eSpark-Backup/eyadkishawi-powerinterface/Design Files/Power_Board/Renderings/3D_Top_View.PNG

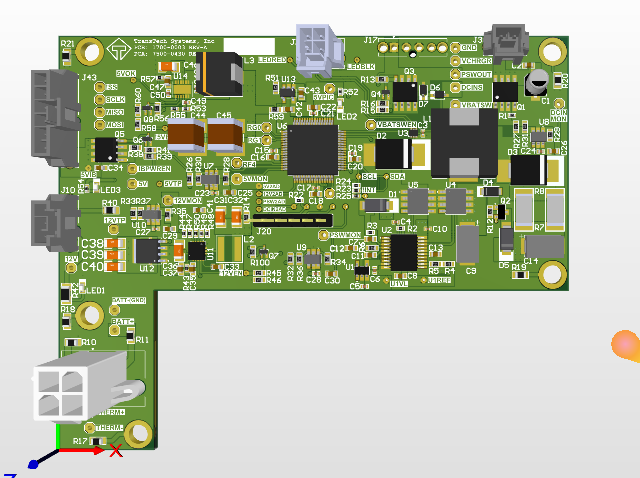
Design Files/Power_Board/Renderings/3D_Top_View.PNG
