eSpark-Backup/eyadkishawi-powerinterface/Design Files/Power_Board/Renderings/2D_C_View.PNG

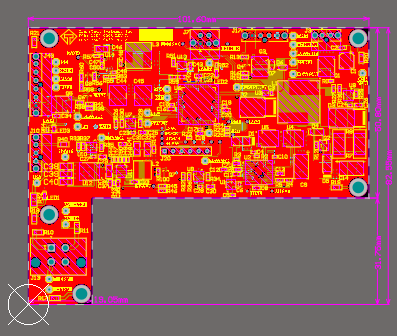
Design Files/Power_Board/Renderings/2D_C_View.PNG
