eSpark-Backup/eyadkishawi-powerinterface/README.md

# Power and Interface Board Design
#### Client Name: Eyad Kishawi
