eSpark-Backup/eyadkishawi-powerinterface/Design Files/Eagle Deliverables/Randerings/2D_TOP.png

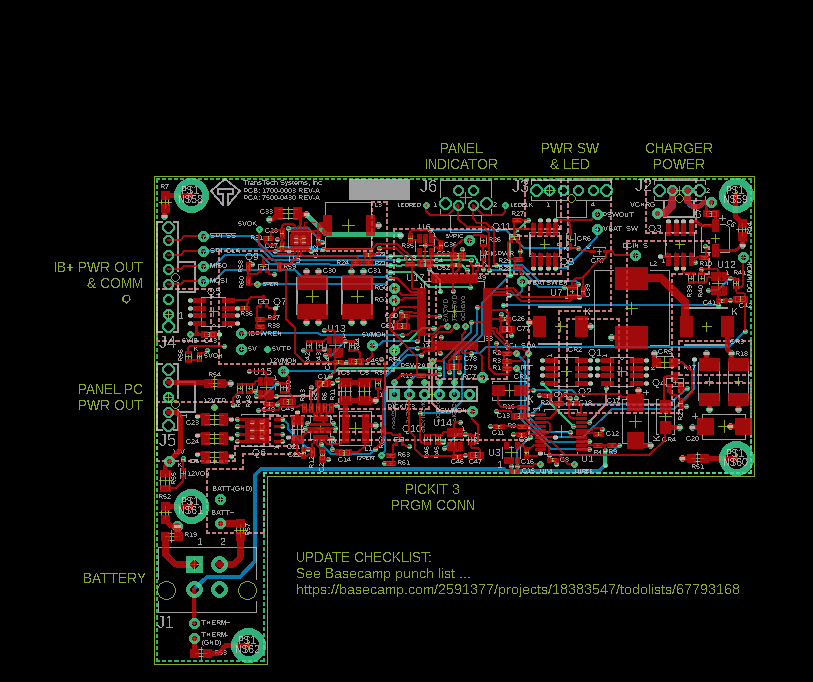
Design Files/Eagle Deliverables/Randerings/2D_TOP.png
