eSpark-Backup/eyadkishawi-powerinterface/Design Files/Power_Board/Renderings/2D_Bottom_Layer.PNG

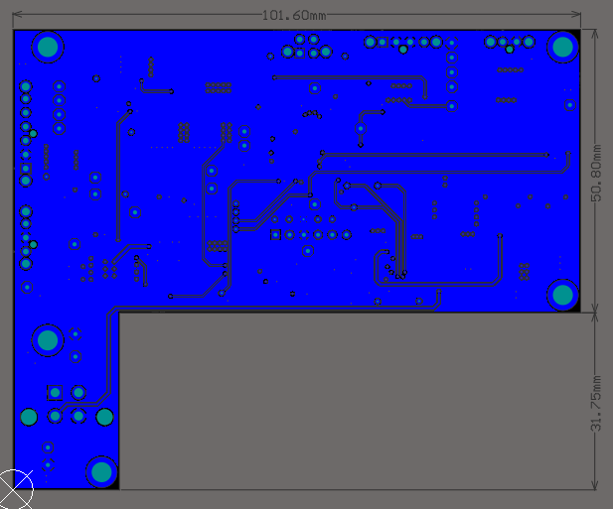
Design Files/Power_Board/Renderings/2D_Bottom_Layer.PNG
