eSpark-Backup/eyadkishawi-powerinterface/Design Files/Power_Board/Renderings/2D_Layer 1.PNG

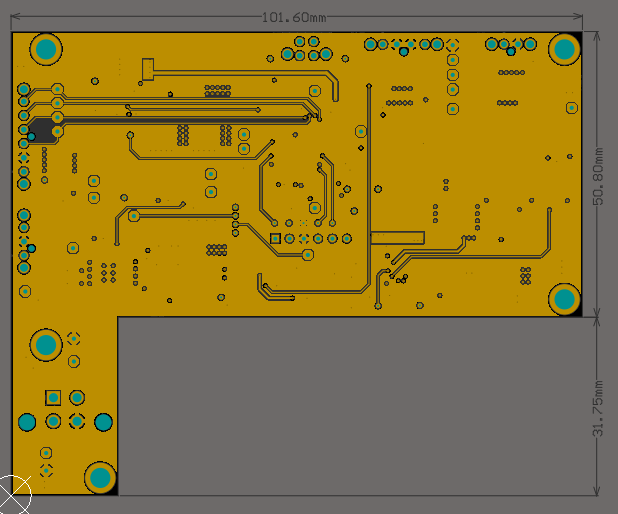
Design Files/Power_Board/Renderings/2D_Layer 1.PNG
