eSpark-Backup/eyadkishawi-powerinterface/Design Files/Power_Board/Renderings/3D_Bottom_View.PNG

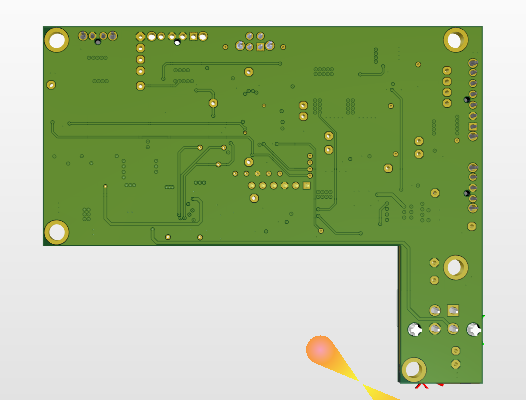
Design Files/Power_Board/Renderings/3D_Bottom_View.PNG
