eSpark-Backup/eyadkishawi-powerinterface/Client_Files/1700-0003_PowerBoard_RevA_071323/7500-0430_PowerBoardAssy_BOM_Rev-A.xlsx

PART | MANUFACTURER | MANUFACTURER_PART_NUMBER | PART_DESC
U4 | TI | TPS61178RNWT | IC REG BOOST ADJ 10A 13VQFN
Q1 | DIODES INC. | DMS3015SSS-13 | N-Channel 30 V 11A (Ta) 1.55W (Ta) Surface Mount 8-SO
Q2 | DIODES INC. | DMS3015SSS-13 | N-Channel 30 V 11A (Ta) 1.55W (Ta) Surface Mount 8-SO
C27 | MURATA |  | --- DO NOT POPULATE ---
U7 | TI | DRV8220DRLR | 20-V, 1-A H-BRIDGE MOTOR DRIVER
C30 | TDK | CKG57NX7R1H476M500JH | 47 µF ±20% 50V Ceramic Capacitor X7R Stacked SMD, 2 J-Lead
C31 | TDK | CKG57NX7R1H476M500JH | 47 µF ±20% 50V Ceramic Capacitor X7R Stacked SMD, 2 J-Lead
Q4 | DIOTEC | BC807-40 | Bipolar Transistors - BJT Bipolar Transistor, SOT-23, 45V, 800mA, PNP
U5 | RENESAS (INTERSIL) | ISL85005AFRZ-T7A | Buck Switching Regulator IC Positive Adjustable 5V 1 Output 5A 12-VFDFN Exposed Pad
C6 | Cornell Dubilier | AFK106M25B12T-F | CAP ALUM 10UF 20% 25V SMD
C8 | MURATA | GCM155R71C104KA55D | CAP CER 0.1UF 16V X7R 0402
C11 | MURATA | GCM155R71C104KA55D | CAP CER 0.1UF 16V X7R 0402
C15 | MURATA | GCM155R71C104KA55D | CAP CER 0.1UF 16V X7R 0402
C16 | MURATA | GCM155R71C104KA55D | CAP CER 0.1UF 16V X7R 0402
C18 | MURATA | GCM155R71C104KA55D | CAP CER 0.1UF 16V X7R 0402
C19 | MURATA | GCM155R71C104KA55D | CAP CER 0.1UF 16V X7R 0402
C26 | MURATA | GCM155R71C104KA55D | CAP CER 0.1UF 16V X7R 0402
C32 | MURATA | GCM155R71C104KA55D | CAP CER 0.1UF 16V X7R 0402
C39 | MURATA | GCM155R71C104KA55D | CAP CER 0.1UF 16V X7R 0402
C41 | MURATA | GCM155R71C104KA55D | CAP CER 0.1UF 16V X7R 0402
C44 | MURATA | GCM155R71C104KA55D | CAP CER 0.1UF 16V X7R 0402
C46 | MURATA | GCM155R71C104KA55D | CAP CER 0.1UF 16V X7R 0402
C48 | MURATA | GCM155R71C104KA55D | CAP CER 0.1UF 16V X7R 0402
C50 | MURATA | GCM155R71C104KA55D | CAP CER 0.1UF 16V X7R 0402
C52 | MURATA | GCM155R71C104KA55D | CAP CER 0.1UF 16V X7R 0402
C78 | MURATA | GCM155R71C104KA55D | CAP CER 0.1UF 16V X7R 0402
C42 | KEMET | C0603C104K3RAC7867 | CAP CER 0.1UF 25V X7R 0603
C45 | KEMET | C0603C104K3RAC7867 | CAP CER 0.1UF 25V X7R 0603
C47 | KEMET | C0603C104K3RAC7867 | CAP CER 0.1UF 25V X7R 0603
C49 | KEMET | C0603C104K3RAC7867 | CAP CER 0.1UF 25V X7R 0603
C7 | SAMSUNG | CL10B104KB8NNNC | CAP CER 0.1UF 50V X7R 0603
C14 | SAMSUNG | CL10B104KB8NNNC | CAP CER 0.1UF 50V X7R 0603
C12 | MURATA | C0402C223K5REC7411 | CAP CER 0402 22NF 50V X7R 10%
C9 | MURATA | C0402C473K3REC7867 | CAP CER 0402 47NF 25V X7R 10%
C43 | MURATA | GRM188D71A106KA73D | CAP CER 10UF 10V X7T 0603
C51 | MURATA | GRM188D71A106KA73D | CAP CER 10UF 10V X7T 0603
C53 | MURATA | GRM188D71A106KA73D | CAP CER 10UF 10V X7T 0603
C77 | MURATA | GRM188D71A106KA73D | CAP CER 10UF 10V X7T 0603
C79 | MURATA | GRM188D71A106KA73D | CAP CER 10UF 10V X7T 0603
C21 | SAMSUNG | CL31B106KBHNNNE | CAP CER 10UF 50V X7R 1206
C29 | MURATA | C0402C120K5RAC7867 | CAP CER 12PF 50V X7R 0402
C28 | MURATA | GRM155R61E105KA12D | CAP CER 1UF 25V X5R 0402
C13 | SAMSUNG | CL10B105KA8NNNC | CAP CER 1UF 25V X7R 0603
C36 | MURATA | GRM155C81C225ME15D | CAP CER 2.2UF 16V X6S 0402
C1 | SAMSUNG | CL10C221JB8NNNC | CAP CER 220PF 50V C0G/NP0 0603
C3 | SAMSUNG | CL31A226KAHNNNE | CAP CER 22UF 25V X5R 1206
C5 | SAMSUNG | CL31A226KAHNNNE | CAP CER 22UF 25V X5R 1206
C33 | SAMSUNG | CL31A226KAHNNNE | CAP CER 22UF 25V X5R 1206
C23 | SAMSUNG | GCM31CC81E226KE11L | CAP CER 22UF 25V X6S 1206
C24 | SAMSUNG | GCM31CC81E226KE11L | CAP CER 22UF 25V X6S 1206
C25 | SAMSUNG | GCM31CC81E226KE11L | CAP CER 22UF 25V X6S 1206
C2 | MURATA | GRM188Z71C475KE21D | CAP CER 4.7UF 16V X7R 0603
C4 | MURATA | GRM188Z71C475KE21D | CAP CER 4.7UF 16V X7R 0603
C17 | KEMET | T495D226K035ATE300 | CAP TANT 22UF 10% 35V 2917
C20 | KEMET | T495D476K025ATE250 | CAP TANT 47UF 10% 25V 2917
J2 | MOLEX | 1053111302 | CONN HEADER VERT 2POS 2.5MM
J5 | MOLEX | 1053111303 | CONN HEADER VERT 3POS 2.5MM
J6 | MOLEX | 1053121304 | CONN HEADER VERT 4POS 2.5MM
J4 | MOLEX | 1053111206 | CONN HEADER VERT 6POS 2.5MM
PICKIT3 | AMPHENOL | 10129378-906001BLF | Connector Header Through Hole 6 position 0.100 (2.54mm)"
CR1 | DIODES INC. | ES1A-13-F | DIODE GEN PURP 50V 1A SMA
CR4 | DIODES INC. | ES1A-13-F | DIODE GEN PURP 50V 1A SMA
CR6 | TOSHIBA | 1SS404 | DIODE SCHOTTKY 20V 300MA USC
CR7 | TOSHIBA | 1SS404 | DIODE SCHOTTKY 20V 300MA USC
CR2 | DIODES INC. | B560CQ-13-F | DIODE SCHOTTKY 60V 5A SMC
CR3 | DIODES INC. | B560CQ-13-F | DIODE SCHOTTKY 60V 5A SMC
CR5 | VISHAY | BZD27C4V3P-E3-08 | DIODE ZENER 4.3V 800MW DO219AB
R31 | --- | --- | DNP - RES 0402
L2 | EATON | DR127-220-R | FIXED IND 22UH 4A 39.1 MOHM SMD
L3 | EATON | DRA74-3R3-R | FIXED IND 3.3UH 4.16A 16MOHM SMD
L1 | COILCRAFT | XAL5030-122MEC | Fixed Inductors 1.2uH Shld 20% 11.1A 9.4mOhms AECQ2
J3 | MOLEX | 1053111304 | HEADER, NANOFIT, VERT, 4 POS 2.5mm
U1 | MAXIM | MAX1647EAP+ | IC BATT CHG MULTI-CHEM 20SSOP
U17 | MICROCHIP | PIC18F6627T-E/PT | IC MCU 8BIT 96KB FLASH 64TQFP
U12 | TI | OPA363AIDBVR | IC OPAMP GP 1 CIRCUIT SOT23-6
U13 | TI | OPA363AIDBVR | IC OPAMP GP 1 CIRCUIT SOT23-6
U14 | TI | OPA363AIDBVR | IC OPAMP GP 1 CIRCUIT SOT23-6
U15 | TI | OPA363AIDBVR | IC OPAMP GP 1 CIRCUIT SOT23-6
5VON | DIALIGHT | 598-8081-107F | LED GREEN CLEAR 0603 SMD
12VON | DIALIGHT | 598-8081-107F | LED GREEN CLEAR 0603 SMD
PICPWR | DIALIGHT | 598-8081-107F | LED GREEN CLEAR 0603 SMD
U6 | STM | LD2981CM50TR | Linear Voltage Regulator IC Positive Fixed 1 Output 100mA SOT-23-5
R23 | VISHAY | MCS0402MD4993BE000 | MCS 0402-25 0.1% AT E0 499K
J1 | MOLEX | 462075004 | MINI-FIT JR LCP VERT. HDR PEGS 4
Q6 | VISHAY | SI7145DP-T1-GE3 | MOSFET P-CH 30V 60A PPAK SO-8
Q3 | ALPHA & OMEGA | AO4485 | MOSFET P-CH 40V 10A 8SOIC
Q5 | ALPHA & OMEGA | AO4485 | MOSFET P-CH 40V 10A 8SOIC
Q8 | ALPHA & OMEGA | AO4485 | MOSFET P-CH 40V 10A 8SOIC
C22 | MURATA | GRM155R71E223KA61D | Multilayer Ceramic Capacitors MLCC - SMD/SMT .022UF 25V 10% 0402
!12VEN |  |  | PCB FEATURE
5V2AD |  |  | PCB FEATURE
5VIB |  |  | PCB FEATURE
5VTP |  |  | PCB FEATURE
12V2AD |  |  | PCB FEATURE
12VTP |  |  | PCB FEATURE
DCIN2AD |  |  | PCB FEATURE
LEDBLK |  |  | PCB FEATURE
LEDRED |  |  | PCB FEATURE
PSW2AD |  |  | PCB FEATURE
U1REF |  |  | PCB FEATURE
U1VL |  |  | PCB FEATURE
PTH1 |  |  | PCB feature, PTH 4-40, ID 148mil, OD 220mil
PTH2 |  |  | PCB feature, PTH 4-40, ID 148mil, OD 220mil
PTH3 |  |  | PCB feature, PTH 4-40, ID 148mil, OD 220mil
PTH4 |  |  | PCB feature, PTH 4-40, ID 148mil, OD 220mil
PTH5 |  |  | PCB feature, PTH 4-40, ID 148mil, OD 220mil
!5VEN |  |  | PCB FEATURE, TEST POINT, ID 20MIL, OD 40MIL
!INT! |  |  | PCB FEATURE, TEST POINT, ID 20MIL, OD 40MIL
5VOK |  |  | PCB FEATURE, TEST POINT, ID 20MIL, OD 40MIL
5VSENS |  |  | PCB FEATURE, TEST POINT, ID 20MIL, OD 40MIL
PICKITGND |  |  | PCB FEATURE, TEST POINT, ID 20MIL, OD 40MIL
PICPGC |  |  | PCB FEATURE, TEST POINT, ID 20MIL, OD 40MIL
PICPGD |  |  | PCB FEATURE, TEST POINT, ID 20MIL, OD 40MIL
SCL |  |  | PCB FEATURE, TEST POINT, ID 20MIL, OD 40MIL
SDA |  |  | PCB FEATURE, TEST POINT, ID 20MIL, OD 40MIL
VPP!MCLR! |  |  | PCB FEATURE, TEST POINT, ID 20MIL, OD 40MIL
!SPI_SS! |  |  | PCB feature, test point, ID 42mil, OD 72mil
5V |  |  | PCB feature, test point, ID 42mil, OD 72mil
5VMON |  |  | PCB feature, test point, ID 42mil, OD 72mil
5VPIC |  |  | PCB feature, test point, ID 42mil, OD 72mil
12V |  |  | PCB feature, test point, ID 42mil, OD 72mil
12VMON |  |  | PCB feature, test point, ID 42mil, OD 72mil
BATT+ |  |  | PCB feature, test point, ID 42mil, OD 72mil
BATT-(GND) |  |  | PCB feature, test point, ID 42mil, OD 72mil
DCINMON |  |  | PCB feature, test point, ID 42mil, OD 72mil
DCIN_S |  |  | PCB feature, test point, ID 42mil, OD 72mil
GND |  |  | PCB feature, test point, ID 42mil, OD 72mil
IBPWREN |  |  | PCB feature, test point, ID 42mil, OD 72mil
MISO |  |  | PCB feature, test point, ID 42mil, OD 72mil
MOSI |  |  | PCB feature, test point, ID 42mil, OD 72mil
PSWMON |  |  | PCB feature, test point, ID 42mil, OD 72mil
PSWOUT |  |  | PCB feature, test point, ID 42mil, OD 72mil
RC7 |  |  | PCB feature, test point, ID 42mil, OD 72mil
RF4 |  |  | PCB feature, test point, ID 42mil, OD 72mil
RG0 |  |  | PCB feature, test point, ID 42mil, OD 72mil
RG1 |  |  | PCB feature, test point, ID 42mil, OD 72mil
SPI_CLK |  |  | PCB feature, test point, ID 42mil, OD 72mil
THERM+ |  |  | PCB feature, test point, ID 42mil, OD 72mil
THERM- |  |  | PCB feature, test point, ID 42mil, OD 72mil
VBATSWEN |  |  | PCB feature, test point, ID 42mil, OD 72mil
VBAT_SW |  |  | PCB feature, test point, ID 42mil, OD 72mil
VCHRG |  |  | PCB feature, test point, ID 42mil, OD 72mil
R7 | STACKPOLE | HCJ0805ZT0R00 | RES 0 OHM JUMPER 1/2W 0805
R14 | STACKPOLE | HCJ0805ZT0R00 | RES 0 OHM JUMPER 1/2W 0805
R19 | STACKPOLE | HCJ0805ZT0R00 | RES 0 OHM JUMPER 1/2W 0805
R51 | STACKPOLE | HCJ0805ZT0R00 | RES 0 OHM JUMPER 1/2W 0805
R52 | STACKPOLE | HCJ0805ZT0R00 | RES 0 OHM JUMPER 1/2W 0805
R53 | STACKPOLE | HCJ0805ZT0R00 | RES 0 OHM JUMPER 1/2W 0805
R54 | STACKPOLE | HCJ0805ZT0R00 | RES 0 OHM JUMPER 1/2W 0805
R57 | STACKPOLE | HCJ0805ZT0R00 | RES 0 OHM JUMPER 1/2W 0805
R17 | TECONN | TLRP3A20CR090FTE | RES 0.09 OHM 1% 2W 2512
R18 | TECONN | TLRP3A20CR090FTE | RES 0.09 OHM 1% 2W 2512
R26 | STACKPOLE | RMCF0603FT1K15 | RES 1.15K OHM 1% 1/10W 0603
R56 | STACKPOLE | RMCF0603FT1K15 | RES 1.15K OHM 1% 1/10W 0603
R16 | VISHAY | CRCW040210R0FKEDC | RES 10 OHM 1% 1/16W 0402
R20 | VISHAY | CRCW040210R0FKEDC | RES 10 OHM 1% 1/16W 0402
R30 | STACKPOLE | RNCS0603BKE10K0 | RES 10K OHM 0.1% 1/16W 0603
R40 | STACKPOLE | RNCS0603BKE10K0 | RES 10K OHM 0.1% 1/16W 0603
R42 | STACKPOLE | RNCS0603BKE10K0 | RES 10K OHM 0.1% 1/16W 0603
R45 | STACKPOLE | RNCS0603BKE10K0 | RES 10K OHM 0.1% 1/16W 0603
R48 | STACKPOLE | RNCS0603BKE10K0 | RES 10K OHM 0.1% 1/16W 0603
R1 | VISHAY | CRCW040210K0FKEDC | RES 10K OHM 1% 1/16W 0402
R2 | VISHAY | CRCW040210K0FKEDC | RES 10K OHM 1% 1/16W 0402
R3 | VISHAY | CRCW040210K0FKEDC | RES 10K OHM 1% 1/16W 0402
R4 | VISHAY | CRCW040210K0FKEDC | RES 10K OHM 1% 1/16W 0402
R8 | VISHAY | CRCW040210K0FKEDC | RES 10K OHM 1% 1/16W 0402
R9 | VISHAY | CRCW040210K0FKEDC | RES 10K OHM 1% 1/16W 0402
R10 | VISHAY | CRCW040210K0FKEDC | RES 10K OHM 1% 1/16W 0402
R15 | VISHAY | CRCW040210K0FKEDC | RES 10K OHM 1% 1/16W 0402
R21 | VISHAY | CRCW040210K0FKEDC | RES 10K OHM 1% 1/16W 0402
R25 | VISHAY | CRCW040210K0FKEDC | RES 10K OHM 1% 1/16W 0402
R27 | VISHAY | CRCW040210K0FKEDC | RES 10K OHM 1% 1/16W 0402
R29 | VISHAY | CRCW040210K0FKEDC | RES 10K OHM 1% 1/16W 0402
R35 | VISHAY | CRCW040210K0FKEDC | RES 10K OHM 1% 1/16W 0402
R36 | VISHAY | CRCW040210K0FKEDC | RES 10K OHM 1% 1/16W 0402
R37 | VISHAY | CRCW040210K0FKEDC | RES 10K OHM 1% 1/16W 0402
R58 | VISHAY | CRCW040210K0FKEDC | RES 10K OHM 1% 1/16W 0402
R59 | VISHAY | CRCW040210K0FKEDC | RES 10K OHM 1% 1/16W 0402
R61 | VISHAY | CRCW040210K0FKEDC | RES 10K OHM 1% 1/16W 0402
R62 | VISHAY | CRCW040210K0FKEDC | RES 10K OHM 1% 1/16W 0402
R5 | STACKPOLE | RMCF0402FT133K | RES 133K OHM 1% 1/16W 0402
R12 | YAGEO | RC0402FR-07178KL | RES 178K OHM 1% 1/16W 0402
R28 | VISHAY | CRCW04021K00FKEDC | RES 1K OHM 1% 1/16W 0402
R38 | VISHAY | CRCW04021K00FKEDC | RES 1K OHM 1% 1/16W 0402
R60 | VISHAY | CRCW04021K00FKEDC | RES 1K OHM 1% 1/16W 0402
R63 | VISHAY | CRCW04021K00FKEDC | RES 1K OHM 1% 1/16W 0402
R55 | VISHAY | CRCW12064K64FKEAC | RES 4.64K OHM 1% 1/4W 1206
R24 | VISHAY | TNPW040295K3BEED | RES 95.3K OHM 0.1% 1/16W 0402
R41 | TECONN | CPF0603F100RC1 | RES SMD 100 OHM 1% 1/16W 0603
R44 | TECONN | CPF0603F100RC1 | RES SMD 100 OHM 1% 1/16W 0603
R47 | TECONN | CPF0603F100RC1 | RES SMD 100 OHM 1% 1/16W 0603
R50 | TECONN | CPF0603F100RC1 | RES SMD 100 OHM 1% 1/16W 0603
R43 | TECONN | CPF0603B15KE1 | RES SMD 15K OHM 0.1% 1/16W 0603
R46 | TECONN | CPF0603B18KE1 | RES SMD 18K OHM 0.1% 1/16W 0603
R39 | TECONN | CPF0603B30KE1 | RES SMD 30K OHM 0.1% 1/16W 0603
R49 | TECONN | CPF0603B30KE1 | RES SMD 30K OHM 0.1% 1/16W 0603
R22 | VISHAY | CRCW040280K6FKED | RES SMD 80.6K OHM 1% 1/16W 0402
R6 | TECONN | CPF0402B86K6E1 | RES SMD 86.6KOHM 0.1% 1/16W 0402
U3 | AD | ADR364AUJZ-REEL7 | Series Voltage Reference IC Fixed 4.096V V ±0.2% 5 mA TSOT-23-5
R11 | VISHAY | CRCW0402174KFKTD | Thick Film Resistors - SMD 1/16watt 174Kohms 1%
R13 | VISHAY | CRCW0402732KFKED | Thick Film Resistors - SMD 1/16watt 732Kohms 1%
Q7 | ONSEMI | MMBT2222ATT3G | TRANS NPN 40V 0.6A SC75 SOT416
Q9 | ONSEMI | MMBT2222ATT3G | TRANS NPN 40V 0.6A SC75 SOT416
Q10 | ONSEMI | MMBT2222ATT3G | TRANS NPN 40V 0.6A SC75 SOT416
Q11 | ONSEMI | MMBT2222ATT3G | TRANS NPN 40V 0.6A SC75 SOT416
