eSpark-Backup/eyadkishawi-powerinterface/Design Files/Power_Board/BOM/Client BOM.xlsx

# | Item Type | Designator | Description | Footprint | Manufacturer Part Number | Manufacturer | Value | Quantity | Remarks
1 | Capacitor | C1 | CAP ALUM 10UF 20% 25V SMD | Custom | EEE-FK1E100R | Panasonic | 10uF | 1
2 | Capacitor | C2, C8, C12, C25, C26, C29, C30, C33 | CAP CER 0.1UF 50V X7R 0603 | Cap-0603 | CL10B104KB8NNNC | Samsung | 0.1uF | 8
3 | Capacitor | C3, C4, C5, C6, C10, C15, C17, C19, C21, C23, C24, C27, C28, C48 | CAP CER 0.1UF 16V X7R 0402 | Cap-0402 | GRM155R71C104KA88D | Murata | 0.1uF | 14
4 | Capacitor | C7, C43, C47 | CAP CER 1UF 25V X5R 0603 | Cap-0603 | CC0603KRX5R8BB105 | Yageo | 1uF | 3
5 | Capacitor | C9 | CAP TANT 22UF 10% 35V 2917 | Case-D | T495D226K035ATE3007280 | KEMET | 22uF | 1
6 | Capacitor | C11 | CAP CER 0.047UF 50V X8R 0603 | Cap-0603 | CGA3E2X8R1H473M080AA | TDK | 47nF | 1
7 | Capacitor | C13, C37 | CAP CER 0.022UF 50V X7R 0603 | Cap-0603 | CC0603KRX7R9BB223 | Yageo | 22nF | 2
8 | Capacitor | C14 | CAP TANT 47UF 10% 25V 2917 | Case-D | T495D476K025ATE250 | KEMET | 47uF | 1
9 | Capacitor | C16, C18, C20, C22 | 10V 10uF X5R ±10% 0603 Multilayer Ceramic Capacitors MLCC - SMD/SMT ROHS | Cap-0603 | CGA0603X5R106K100JT | HRE | 10uF | 4
10 | Capacitor | C31, C32, C38, C39, C40, C46 | Multilayer Ceramic Capacitor, 22 uF, 25 V, ± 20%, X5R, 1206 [3216 Metric] | Cap-1206 | C3216X5R1E226M160AB | TDK | 22uF | 6
11 | Capacitor | C34 | CAP CER 10UF 10V X5R 0603 | Cap-0603 | CC0603KRX5R6BB106 | Yageo | 10uF | 1
12 | Capacitor | C35, C42 | CAP CER 4.7UF 16V X5R 0603 | Cap-0603 | CC0603KRX5R7BB475 | Yageo | 4.7uF | 2
13 | Capacitor | C36 | CAP CER 10UF 50V X5R 1206 | Cap-1206 | CC1206KKX5R9BB106 | Yageo | 10uF | 1
14 | Capacitor | C41 | 50V 220pF X7R ±10% 0603 Multilayer Ceramic Capacitors MLCC - SMD/SMT ROHS | Cap-0603 | CS1608X7R221K500NRB | Samwha Capacitors | 220pF | 1
15 | Capacitor | C44, C45 | CAP CER 47UF 50V X7R 2SMD | Custom | CKG57NX7R1H476M500JH | TDK | 47uF | 2
16 | Capacitor | C49 | CAP CER 12PF 50V C0G/NP0 0402 | Cap-0402 | GJM1555C1H120GB01D | Murata | 12pF | 1
17 | Capacitor | C50 | CAP CER 0.1UF 16V X7R 0402 | Cap-0402 | GRM155R71C104KA88D | Murata | DNP | 1 | DO NOT PLACE
18 | Diodes | D1, D5 | DIODE GEN PURP 50V 1A SMA | SMA | ES1A-13-F | Diodes | - | 2
19 | Diode | D2, D3 | DIODE SCHOTTKY 60V 5A SMC | SMC | B560CQ-13-F | Diodes | - | 2
20 | Diodes | D4 | Zener Diode, 4.3V V(Z), 6.98%, 0.8W, Silicon, Unidirectional, DO-219AB | DO-219AB (SMF) | BZD27C4V3P-E3-08 | Vishay Semiconductors | - | 1
21 | Diode | D6, D7 | Diode Schottky Barrier 25V 0.3A 2 SOD-323 | SOD-323 | 1SS404,H3F | Toshiba | - | 2
22 | Headers | J3 | CONN HEADER VERT 2POS 2.5MM | TH-2.5mm | 1053111302 | Molex | - | 1
23 | Header | J7 | CONN HEADER VERT 4POS 2.5MM | TH-2.5mm | 105312-1304 | Molex | - | 1
24 | Header | J10 | CONN HEADER VERT 3POS 2.5MM | TH-2.5mm | 105311-1303 | Molex | - | 1
25 | Header | J13 | MINI-FIT JR LCP VERT. HDR PEGS 4 | TH-4.2mm | 462075004 | Molex | - | 1
26 | Header | J17 | CONN HEADER VERT 4POS 2.5MM | TH-2.5mm | 105311-1304 | Molex | - | 1
27 | Header | J20 | Gold 250V 3A Straight Square Pins 2.5mm 6P 260℃ 6mm -40℃~+105℃ 3mm 2.54mm Plugin Black Brass 1x6P Plugin,P=2.54mm Pin Headers ROHS | TH-2.5mm | X6511WV-06H-C60D30 | XKB | - | 1
28 | Header | J43 | CONN HEADER VERT 6POS 2.5MM | TH-2.5mm | 105311-1206 | Molex | - | 1
29 | Inductors | L1 | FIXED IND 22UH 4A 39.1 MOHM SMD | Custom | DR127-220-R | Eaton Cooper | 22uH | 1
30 | Inductors | L2 | FIXED IND 1.2UH 10.4A 12.4MOHM | Custom | XAL5030-122MEC | Coilcraft | 1.2uH | 1
31 | Inductors | L3 | FIXED IND 3.3UH 4.16A 16MOHM SMD | Custom | DRA74-3R3-R | Eaton Cooper | 3.3uH | 1
32 | LED | LED1, LED2, LED3 | Emerald 0603 Light Emitting Diodes (LED) ROHS | LED-0603 | NCD0603G2 | Foshan NationStar Optoelectronics | - | 3
33 | Transistor | Q1, Q3, Q5 | MOSFET P-CH 40V 10A 8SOIC | SOIC-8 | AO4485 | Alpha & Omega Semiconductor | - | 3
34 | Transistor | Q2 | 45V 310mW 250@100mA,1V 800mA SOT-23 Bipolar (BJT) ROHS | SOT-23 | BC807-40 | KEXIN | - | 1
35 | Transistor | Q4, Q6, Q7, Q8 | Small Signal Bipolar Transistor, 0.6A I(C), 40V V(BR)CEO, 1-Element, NPN, Silicon | SOT-416 | MMBT2222ATT3G | ON Semiconductor | - | 4
36 | Resistor | R1, R22, R23, R24, R25 | RES 10K OHM 1% 1/16W 0402 | Res-0402 | RC0402FR-0710KL | Yageo | 10K | 5
37 | Resistor | R2, R3 | RES SMD 10 OHM 1% 1/5W 0402 | Res-0402 | CRCW040210R0FKEDHP | Vishay Dale | 10R | 2
38 | Resistor | R4, R5, R6, R12, R13, R16, R38, R41, R46, R51, R56, R59, R60, R100 | RES 10K OHM 1% 1/10W 0603 | Res-0603 | RK73G1JTTD1002F | KOA Speer Electronics, Inc. | 10K | 14
39 | Resistor | R26, R31, R36, R37 | RES 10K OHM 0.1% 1/16W 0603 | Res-0603 | RNCS0603BKE10K0 | Stackpole Electronics Inc | 10K | 4
40 | Resistor | R7, R8 | Res Current Sense Metal Strip 2512 0.09 Ohm 1% 2W ±25ppm/°C Molded Emboss T/R | RES-2512 | TLRP3A20CR090FTE | CGS | 90mR | 2
41 | Resistor | R10, R11, R17, R18, R19, R20, R21 | RES 0 OHM JUMPER 1/8W 0805 | Res-0805 | RC0805FR-070RL | Yageo | 0R | 7
42 | Resistor | R14 | RES SMD 10K OHM 0.1% 1/10W 0603 | Res-0603 | RT0603BRD0710KL | Yageo | 10K | 1
43 | Resistor | R15, R39, R45, R58 | RES SMD 1K OHM 1% 1/10W 0603 | Res-0603 | RC0603FR-071KL | Yageo | 1K | 4
44 | Resistor | R27, R33 | RES SMD 30K OHM 0.1% 1/16W 0603 | Res-0603 | CPF0603B30KE1 | TE Connectivity Passive Product | 30K | 2
45 | Resistor | R28, R29, R34, R35 | RES SMD 100 OHM 1% 1/10W 0603 | Res-0603 | RC0603FR-07100RL | Yageo | 100R | 4
46 | Resistor | R30 | RES SMD 15K OHM 0.1% 1/16W 0603 | Res-0603 | CPF0603B15KE1 | TE Connectivity Passive Product | 15K | 1
47 | Resistor | R32 | RES SMD 18K OHM 0.1% 1/16W 0603 | Res-0603 | CPF0603B18KE1 | TE Connectivity Passive Product | 18K | 1
48 | Resistor | R40 | HCJ Series 0805 Jumper Surface Mount Chip Resistor | Res-0805 | HCJ0805ZT0R00 | Stackpole Electronics | 0R | 1
49 | Resistor | R42 | 250mW Thick Film Resistors 200V ±100ppm/℃ ±1% 4.64kΩ 1206 Chip Resistor - Surface Mount ROHS | Res-1206 | 1206W4F4641T5E | UNI-ROYAL | 4.64K | 1
50 | Resistor | R44 | 62.5mW Thick Film Resistors ±1% ±200ppm/℃ 732kΩ 0402 Chip Resistor - Surface Mount ROHS | Res-0402 | RC-02W7323FT | FH (Guangdong Fenghua Advanced Tech) | 732K | 1
51 | Resistor | R47 | 62.5mW Thick Film Resistors 75V ±1% ±100ppm/℃ 80.6kΩ 0402 Chip Resistor - Surface Mount ROHS | Res-0402 | CRCW040280K6FKED | Vishay Intertech | 80.6K | 1
52 | Resistor | R48 | 62.5mW Thick Film Resistors 50V ±1% ±200ppm/℃ 174kΩ 0402 Chip Resistor - Surface Mount ROHS | Res-0402 | CR0402FF1743G | LIZ Elec | 174K | 1
53 | Resistor | R49 | 62.5mW Thick Film Resistors 50V ±100ppm/℃ ±1% 86.6kΩ 0402 Chip Resistor - Surface Mount ROHS | Res-0402 | RM04FTN8662 | TA-I Tech | 86.6K | 1
54 | Resistor | R43,R50 | 62.5mW Thick Film Resistors 50V ±100ppm/℃ ±1% 133kΩ 0402 Chip Resistor - Surface Mount ROHS | Res-0402 | RTT021333FTH | RALEC | 133K | 2
55 | Resistor | R52, R54 | 100mW Thick Film Resistors 75V ±100ppm/℃ ±1% 1.15kΩ 0603 Chip Resistor - Surface Mount ROHS | Res-0402 | RTT031151FTP | RALAC | 1.15K | 2
56 | Resistor | R53 | RES 499K OHM 0.1% 1/16W 0402 | Res-0402 | RC0402BR-07499KL | Yageo | 499K | 1
57 | Resistor | R55 | RES 95.3K OHM 1% 1/16W 0402 | Res-0402 | RC0402FR-0795K3L | Yageo | 95.3K | 1
58 | Resistor | R57 | RES 95.3K OHM 1% 1/16W 0402 | Res-0402 | RC0402FR-0795K3L | Yageo | DNP | 1 | DO NOT PLACE
59 | IC | U1 | IC VREF SERIES 0.2% TSOT5 | TSOT-23-5 | ADR364AUJZ-REEL7 | Analog Devices | - | 1
60 | IC | U2 | Battery Charger Lead-Acid/Li-Ion/NiCD/NiMH 4000mA 18V 20-Pin SSOP | SSOP-20-208mil | MAX1647EAP+ | Maxim | - | 1
61 | IC | U3 | 20-V, 1-A H-BRIDGE MOTOR DRIVER | SOT-563 | DRV8220DRLR | Texas Instruments | - | 1
62 | IC | U4, U5 | MOSFET N-CH 30V 11A 8SO | SOP-8 | DMS3015SSS-13 | Diodes | - | 2
63 | IC | U6 | IC MCU 8BIT 96KB FLASH 64TQFP | 64-TQFP (10x10) | PIC18F6627T-E/PT | Microchip | - | 1
64 | IC | U7, U8, U9, U10 | IC OPAMP GP 1 CIRCUIT SOT23-6 | SOT-23-6 | OPA363AIDBVR | Texas Instruments | - | 4
65 | IC | U11 | 20-V, 10-A fully integrated sync boost with load disconnect 13-VQFN-HR -40 to 85 | VQFN-13-HR(3x3.5) | TPS611781RNWT | Texas Instruments | - | 1
66 | MOSFET | U12 | MOSFET P-CH 30V 60A PPAK SO-8 | PowerPAK-SO-8 | SI7145DP-T1-GE3 | Vishay Siliconix | - | 1
67 | IC | U13 | LD2981 Series 100 mA 5 V Fixed Output LDO Regulator with Inhibit - SOT-23-5 | SOT-23-5 | LD2981CM50TR | STMicroelectronics | - | 1
68 | IC | U14 | IC REG BUCK ADJ 5A 12DFN | 12-DFN (4x3) | ISL85005AFRZ-T7A | Renesas Electronics Corporation | - | 1
