eSpark-Backup/eyadkishawi-powerinterface/Design Files/Eagle Deliverables/Supporting Files/1700-0003_PowerBoard_REV-A.step

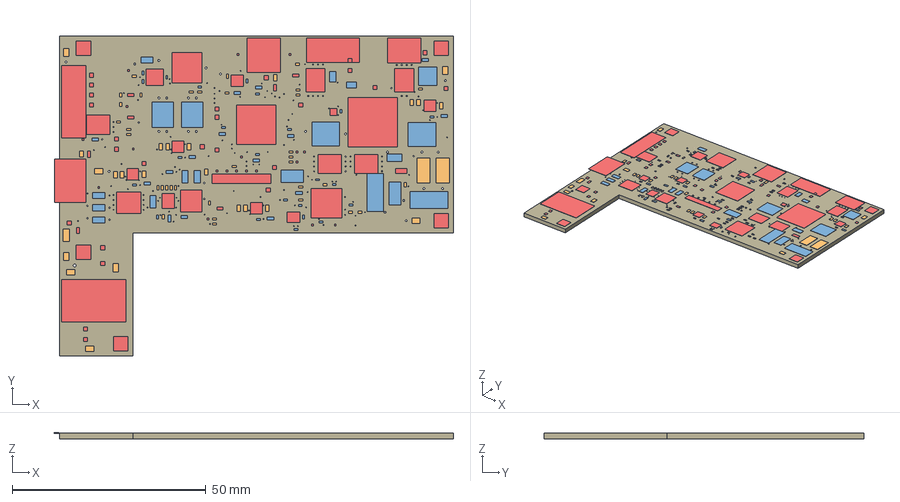
[picture p10: CAD file, 2024-07-15]
Design Files/Eagle Deliverables/Supporting Files/1700-0003_PowerBoard_REV-A.step
102.8 x 82.5 x 1.66 mm
Board
MOLEX_1053111206
TST_POINT_PTH_042-OCT x 22
DNP (0402) x 34
MOLEX_MINI-FIT-JR_462075004
MAX1647EAP+
MOLEX_NANO-FIT_1053111302
MOLEX_NANO-FIT_1053111303
0.1/16V (0402) x 23
AD_REFERENCE_ADR364AUJZ-REEL7
P-CH/40V/10A/8-SOIC x 5
47/25 x 2
1A/50V x 2
22uH/4A/39mOhm
5A/60V/SMC x 2
0.09/2W/2512 x 2
45V/0.8A/SOT23
4.3V/0.8W/DO219AB
REGULATOR_BOOST_TI_TPS61178RNWT
REGULATOR_BUCK_RENESAS_ISL85005AFRZ-T7A
0.1/50V x 15
22/25V (1206) x 7
1.2uH/11.1A/9.4mOhm
P-CH/-30V/-60A/PPAK/SO-8
47/50V x 2
3.3uH/4.2A
NPN/40V/0.6A/SC75 x 4
IC_OPAMP_TI_OPA363AIDBVR x 4
10K, 0.1% x 15
GRN/2.7V/2mA x 3
4.64K
PIC18F6627T-E/PT
IC_LDO_STM_LD2981CM50TR
PTH_4-40 x 5
CON_6POS_VERT-HDR_AMPH_10129378-906001
TST_POINT_PTH_042_2PIN x 4
MOLEX_NANO-FIT_1053111304
0.3A/20V x 2
CON_MOLEX_NANOFIT_1053121304
IC_H-BRIDGE_TI_DRV8220DRLR
TST_POINT_PTH_20X40MIL_2PIN x 10
TST_POINT_PTH_20X40MIL x 12
10/25
