eSpark-Backup/eyadkishawi-powerinterface/Design Files/Power_Board/Supporting Files/PCB_PowerBoard_7500-0430.step

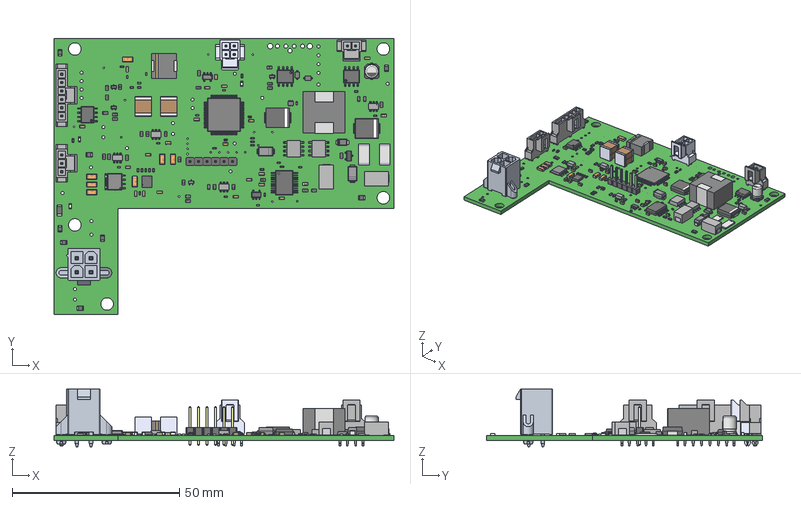
[picture p11: CAD file, 2024-08-13]
Design Files/Power_Board/Supporting Files/PCB_PowerBoard_7500-0430.step
101.6 x 82.5 x 17.3 mm
User Library-Capacitor 0402 x 16
User Library-RES_1005-0402 x 18
User Library-CR3216-1206
CircuitWorks-RESISTOR 2512 x 2
SN74LV1T34DBVR
SQJ148EP-T1_GE3_SQJ148EP-T1_GE3
21-0058I_MXM x 4
TQFP64_10x10MC_MCH
TRANS_IRF7103TRPBF_INF x 2
SOT_X-T1-GE3_VIS
MT8870DN1
User Library-tsot-23-5
User Library-RESC1608X05N x 31
User Library-CR2012-0805 x 8
User Library-SOIC-8-1 x 3
CircuitWorks-SOT-23
User Library-LED SMD0603 x 3
IND_CB_DRA74
DR127
User Library-Header_Male_6Pin_PinArray
User Library-Header_Male_6Pin_BodyArray
1053111303_RGB8421504
1053111302_RGB8421504
User Library-DO-214AC SMA x 2
User Library-DO-214AB-SMC x 2
User Library-CAPC1608X09 x 22
User Library-1206 SMD Capacitor x 7
標準品ケースΦ4x5.3L SIDE CODE B
標準品座版Φ4 SIZE CODE B
標準品リード線Φ4 SIZE CODE B x 2
