eSpark-Backup/eyadkishawi-powerinterface/(list of files, cad)

Other CAD files:
Design Files/Eagle Deliverables/Supporting Files/1700-0003_PowerBoard_REV-A.dxf
Design Files/Power_Board/Supporting Files/PCB_PowerBoard_7500-0430.DWG
Design Files/Power_Board/Supporting Files/PCB_PowerBoard_7500-0430.DXF
