eSpark-Backup/eyadkishawi-powerinterface/Design Files/Power_Board/Schematics/PowerBoard_7500-0430.pdf

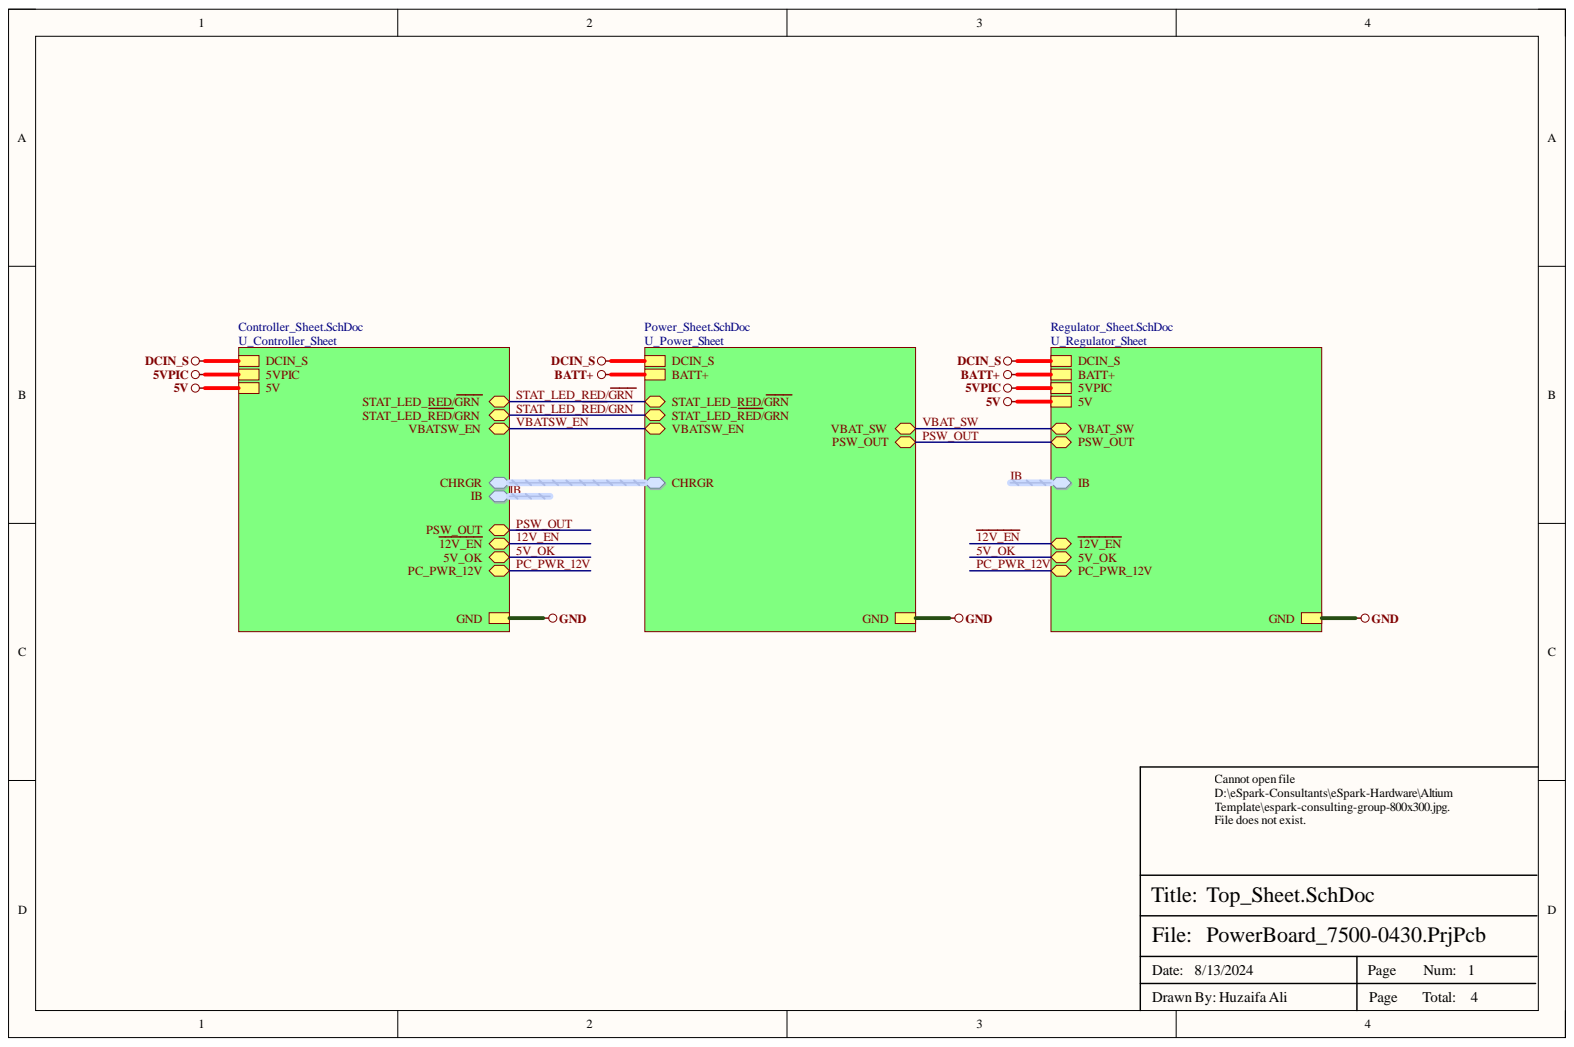
[picture p12: page 1]

Dat e : 8 / 1 3 / 2 0 2 4 | Pag e N u m :

D raw n B y : H uzai fa A l i | Pag e To t al :

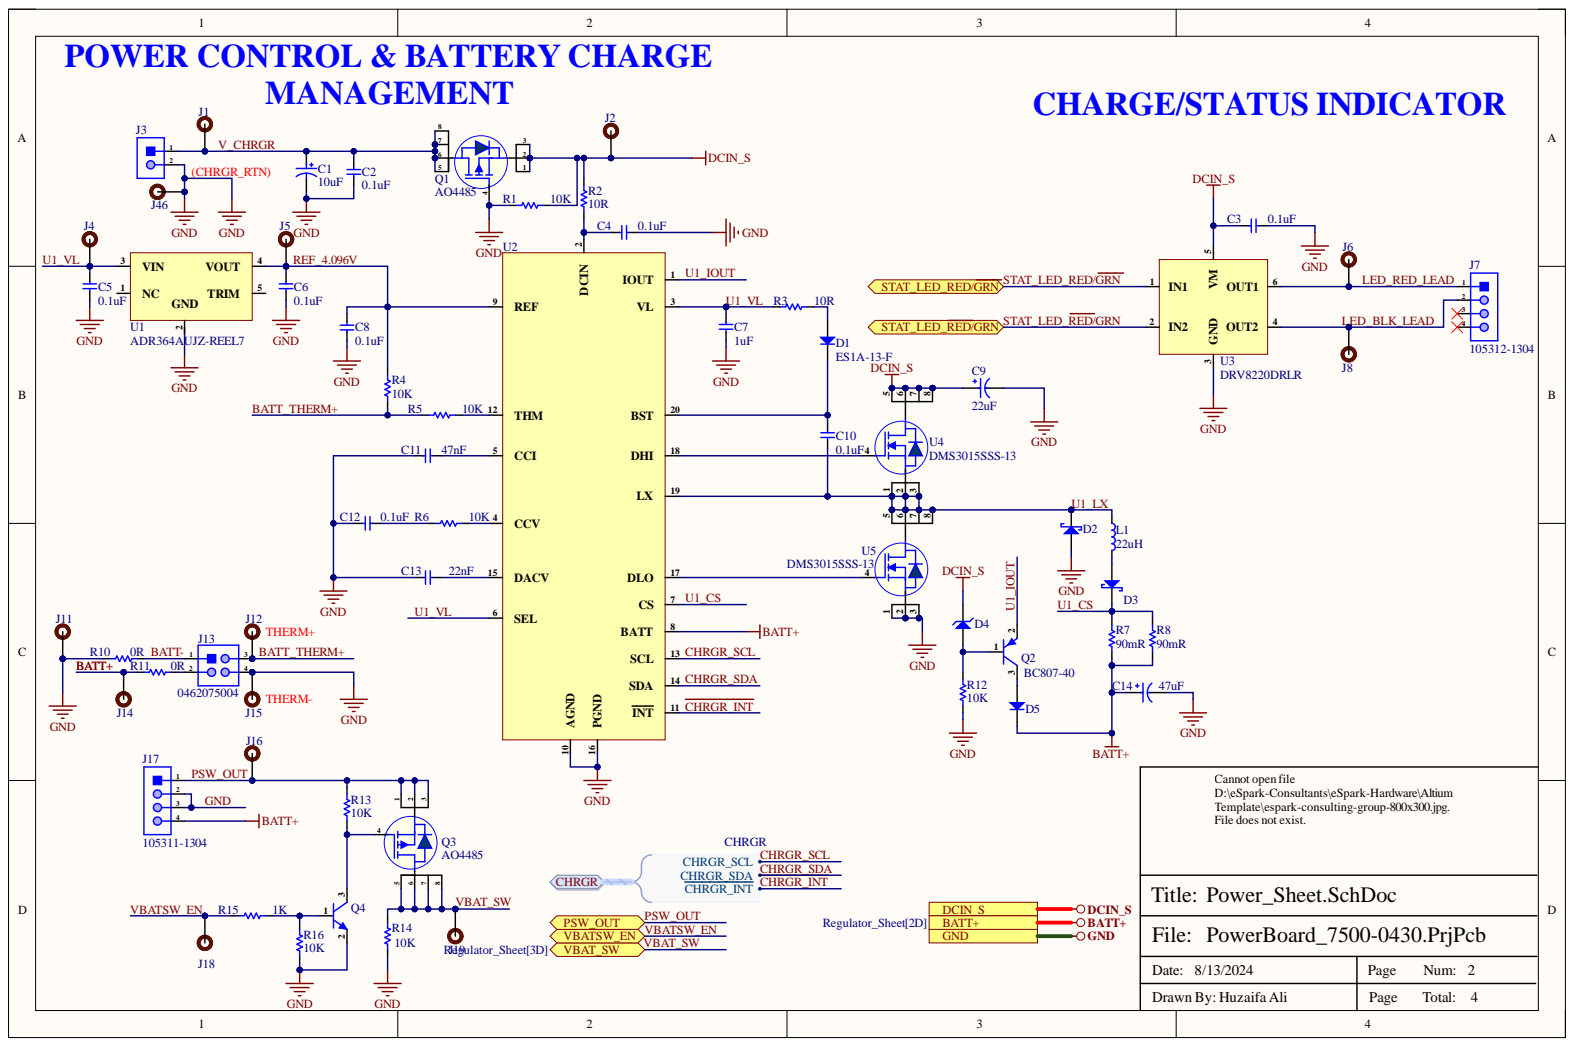
[picture p13: page 2]

POWER CONTROL & BATTERY CHARGE

LED_BLK_LEAD | 3

Cannot open file
D:\eSpark-Consultants\eSpark-Hardware\Altium
Template\espark-consulting-group-800x300.jpg.
File does not exist.

Date: 8/13/2024 | Page Num: 2

Drawn By: Huzaifa Ali | Page Total: 4

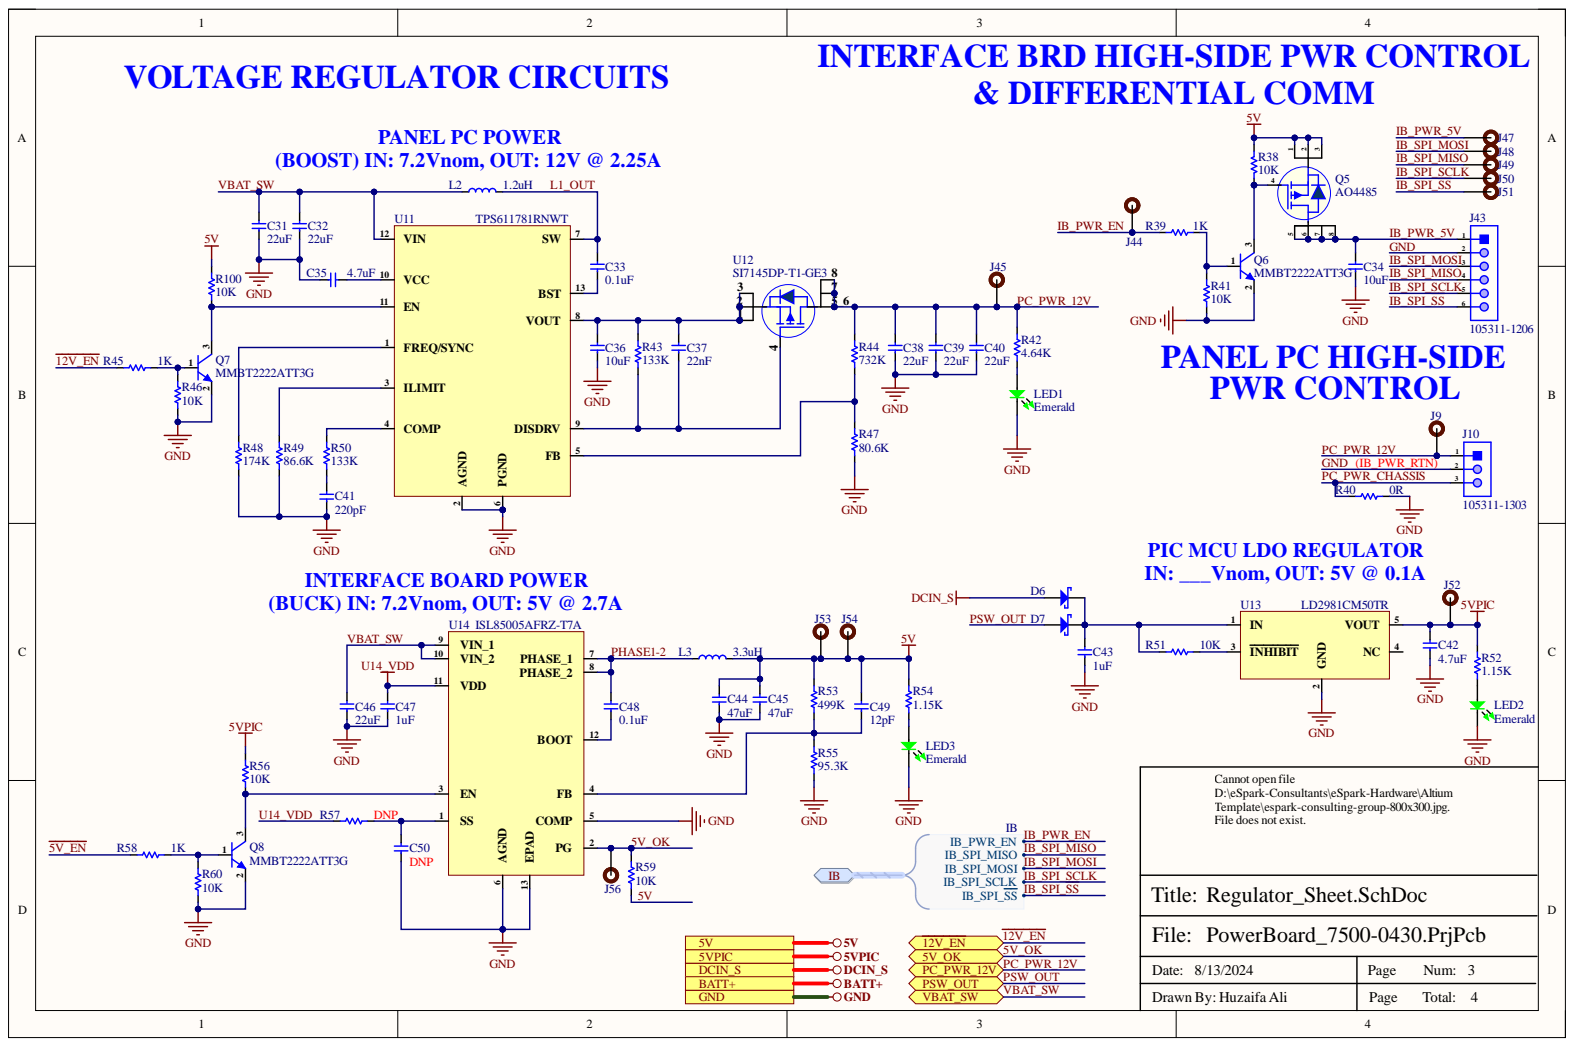
[picture p14: page 3]

INTERFACE BRD HIGH-SIDE PWR CONTROL

PANEL PC HIGH-SIDE
PWR CONTROL

GND

PIC MCU LDO REGULATOR
IN: ___Vnom, OUT: 5V @ 0.1A

U14_VDD

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

Date: 8/13/2024 | Page Num: 3

Drawn By: Huzaifa Ali | Page Total: 4

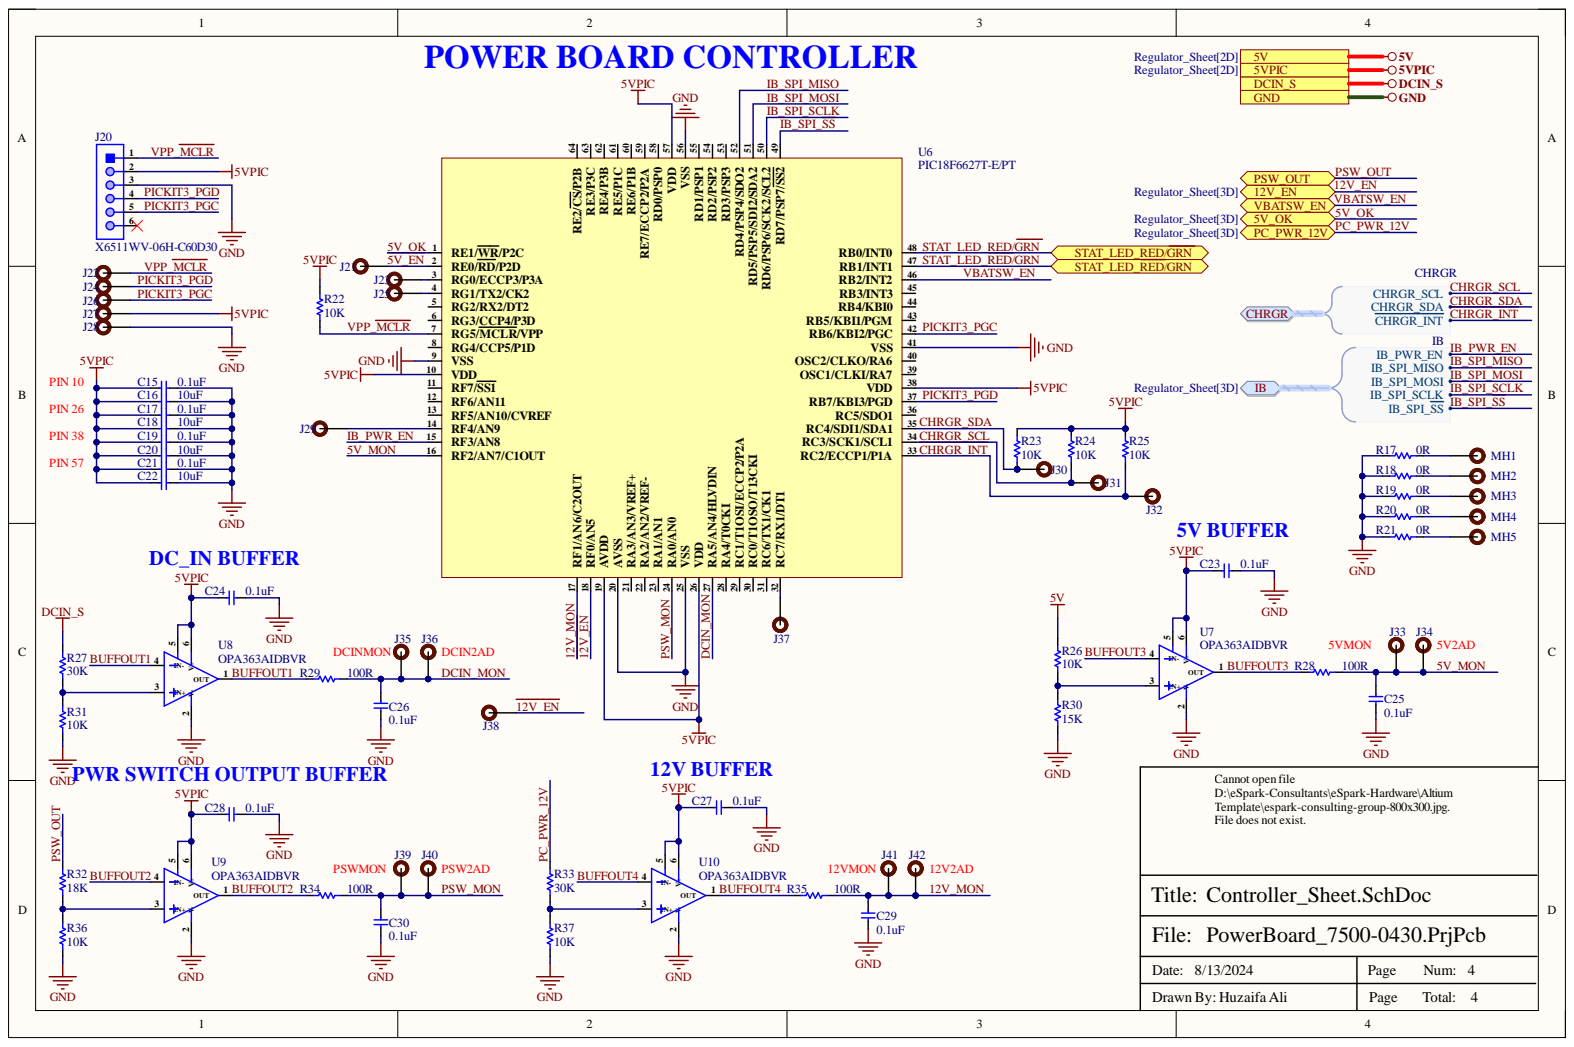
[picture p15: page 4]

C21 | 0.1uF
C22 | | 10uF

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

Date: 8/13/2024 | Page Num: 4

Drawn By: Huzaifa Ali | Page Total: 4

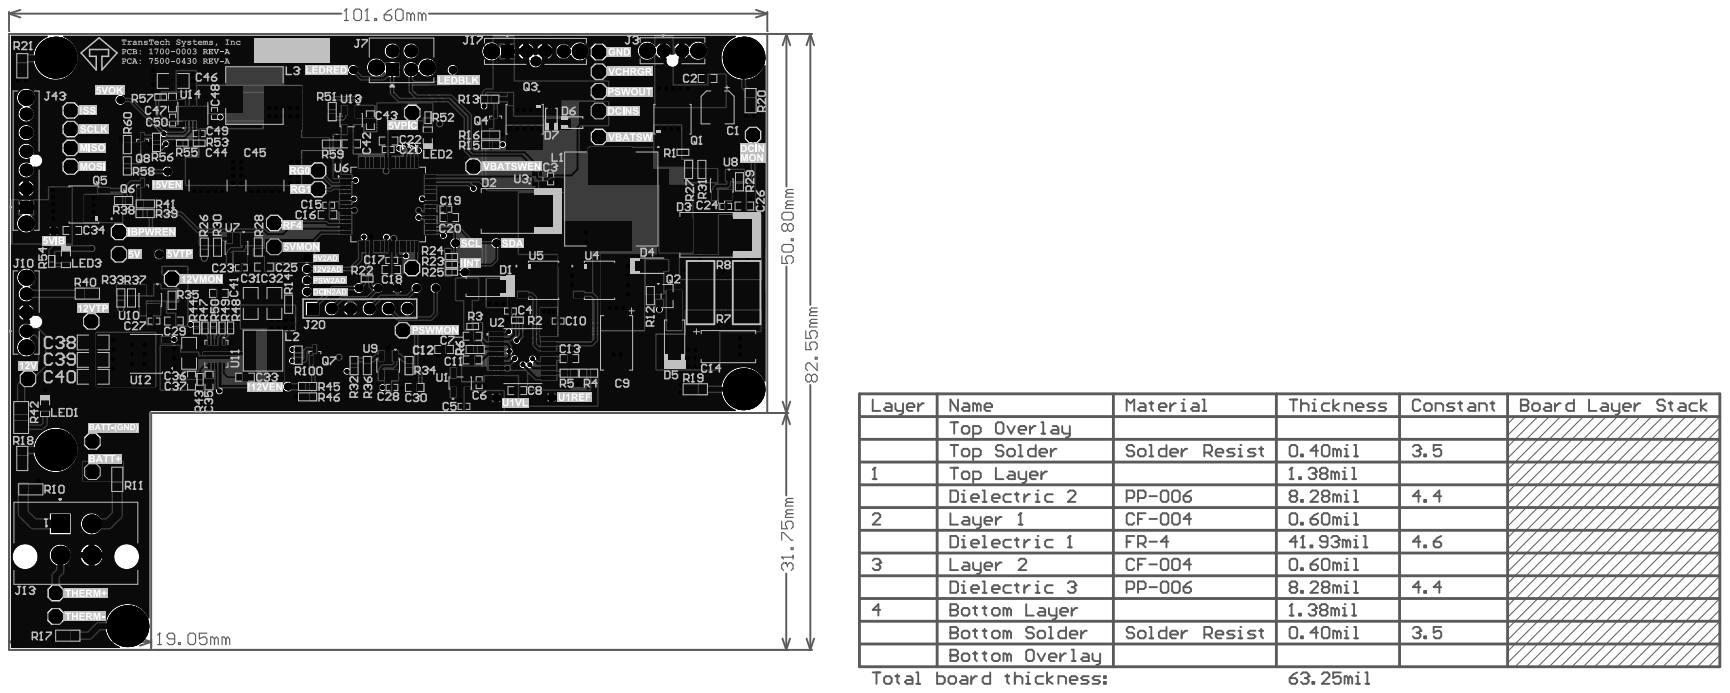
[picture p16: page 5]
