eSpark-Backup/eyadkishawi-powerinterface/Design Files/Eagle Deliverables/PCB_PDF/Power Board.pdf

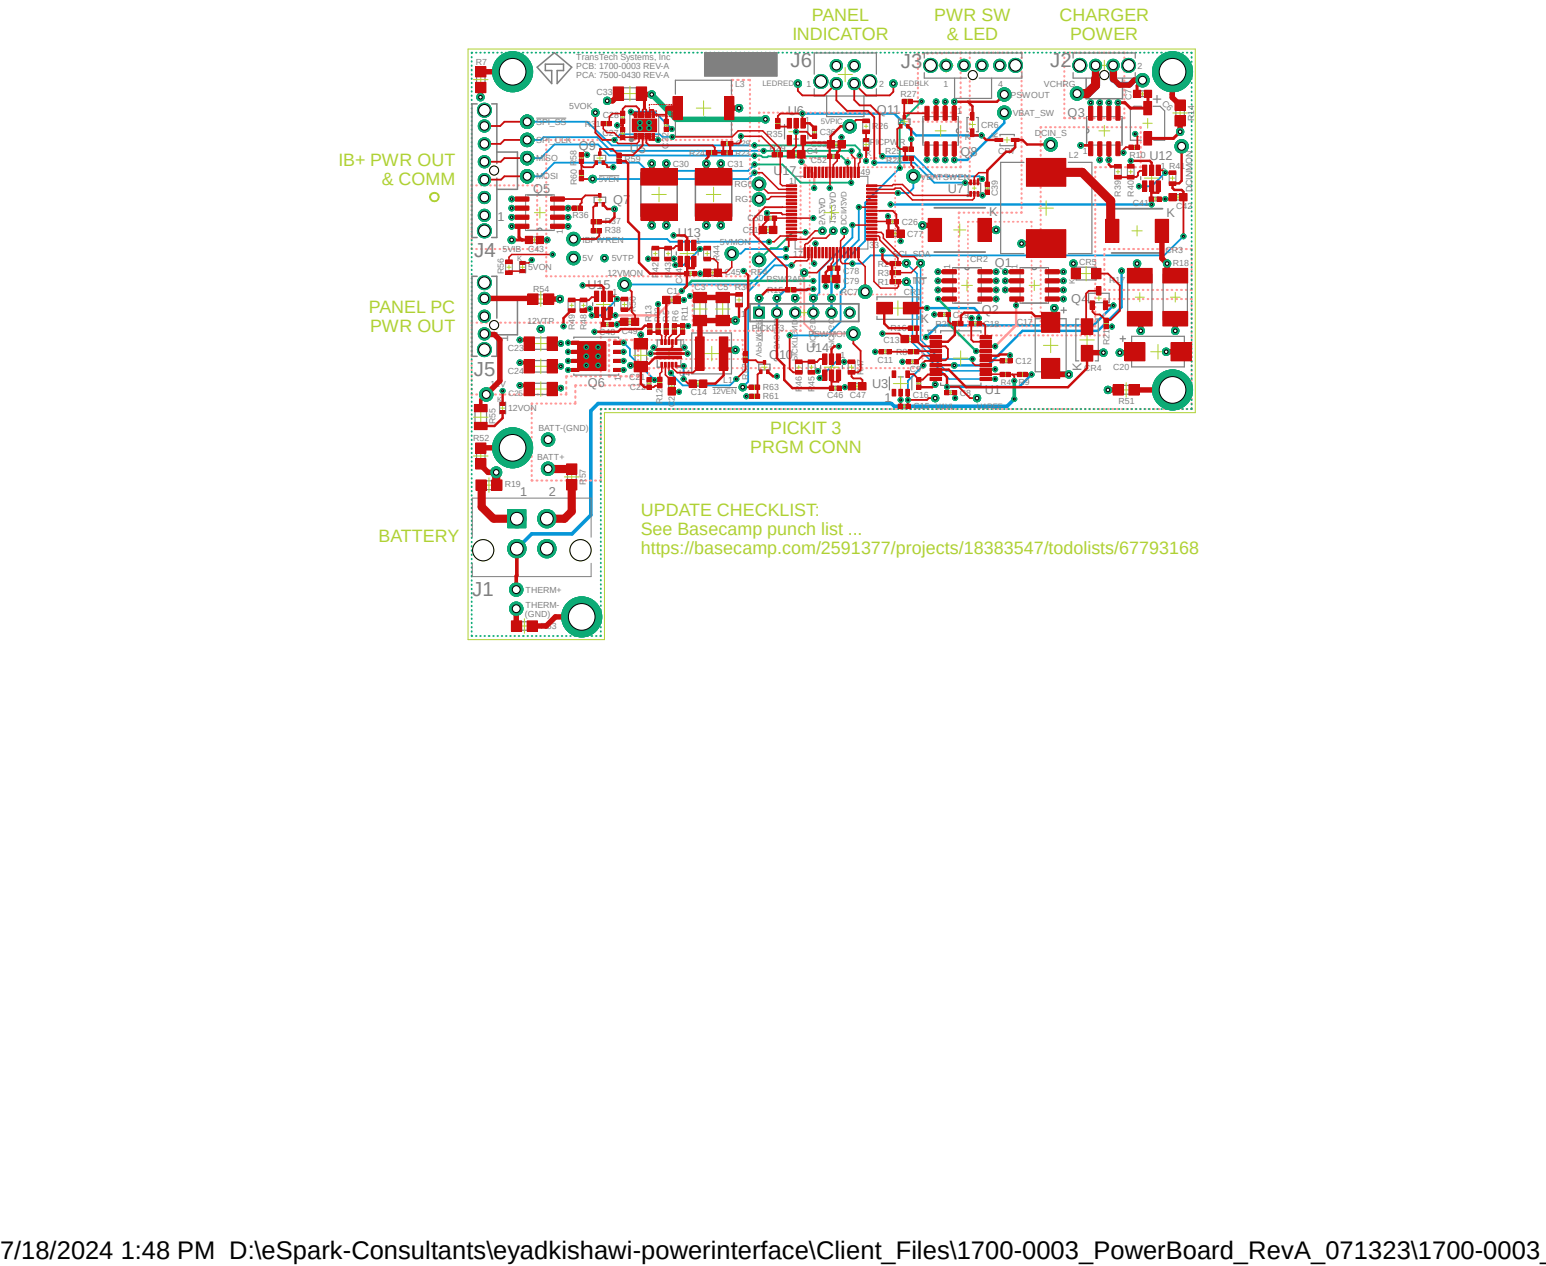
[picture p18: page 1]

J3 R⁵⁷
TransTech Systems, Inc PCB: 1700-0003 REV-A
PCA: 7500-0430 REV-A

UPDATE CHECKLIST:
See Basecamp punch list ...
https://basecamp.com/2591377/projects/18383547/todolists/67793168
