eSpark-Backup/eyadkishawi-powerinterface/Design Files/Eagle Deliverables/Schematic PDF/Power Board.pdf

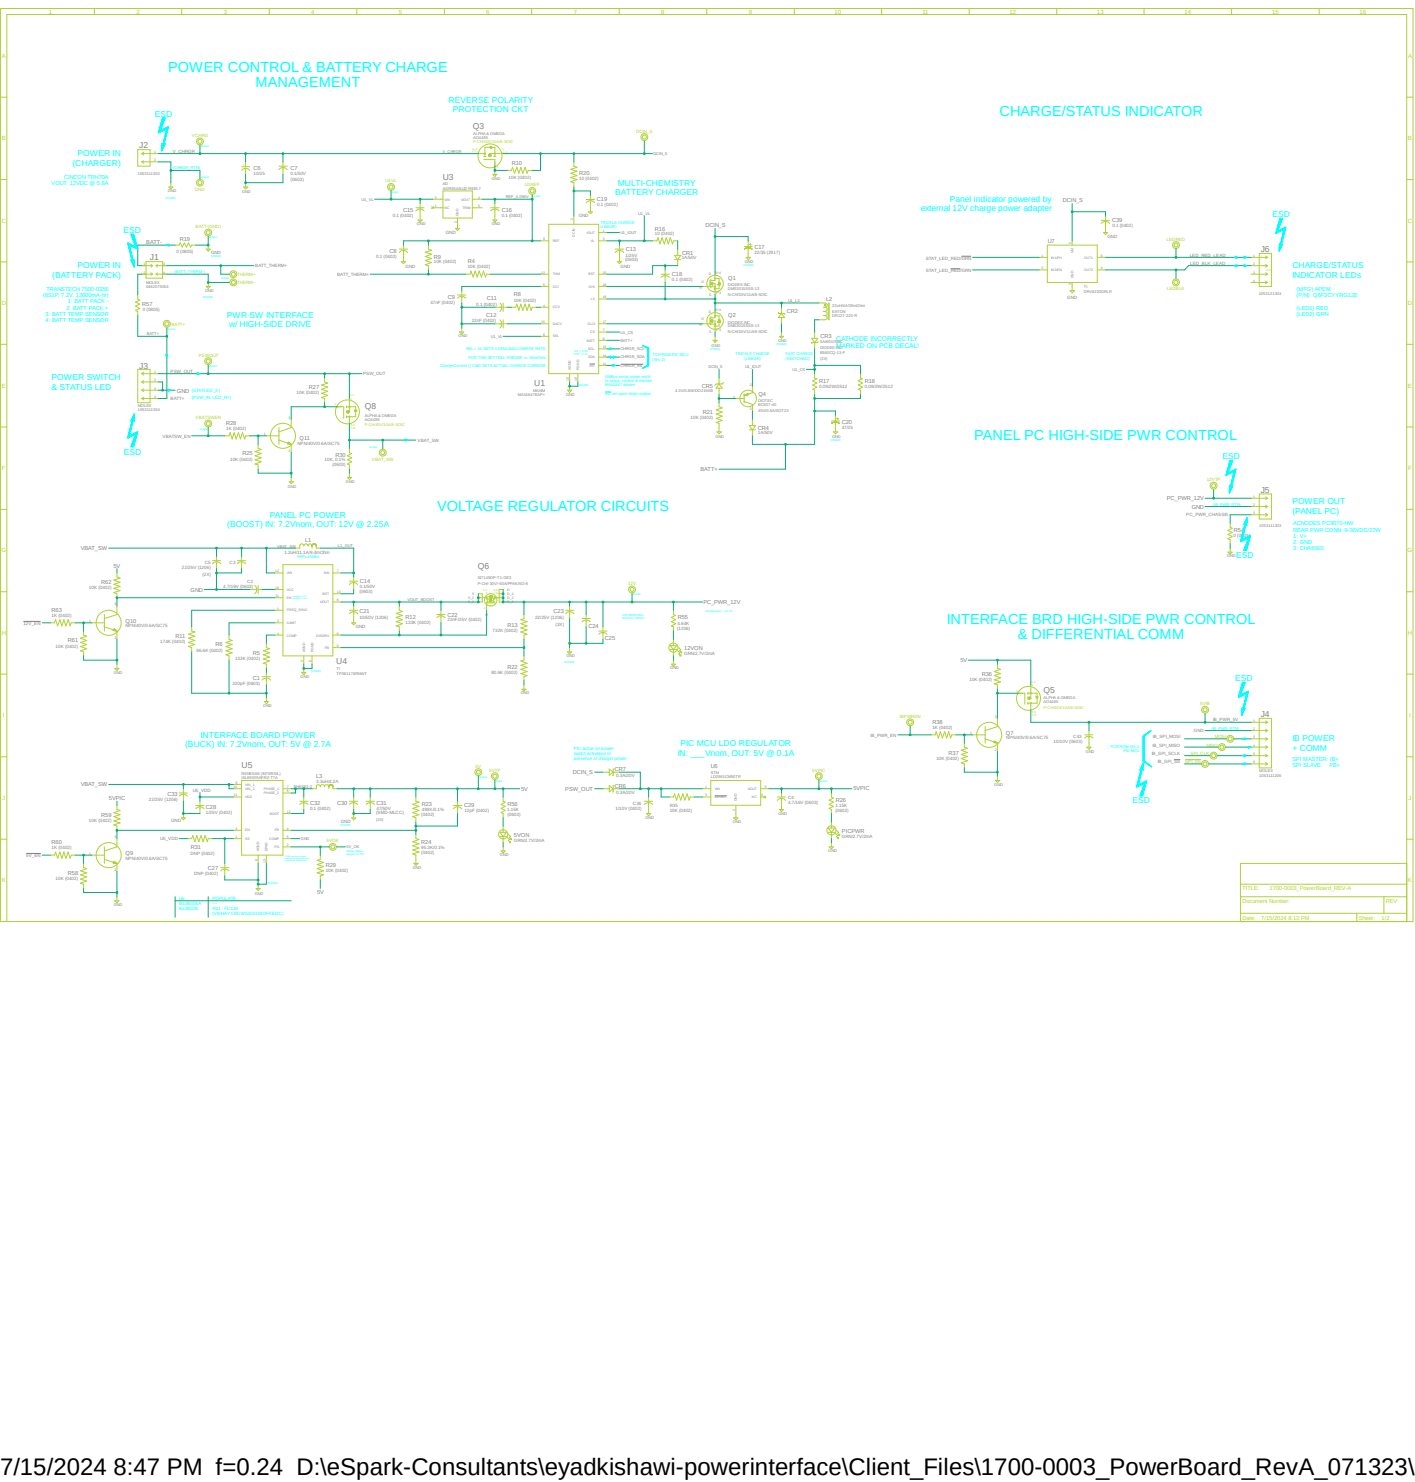
[picture p19: page 1]

POWER CONTROL & BATTERY CHARGE

Panel indicator powered by

external 12V charge power adapter

SEL = VL SETS 4.095A MAX CHARGE RATE.
FOR THIS SETTING, RSENSE == 45mOhm.

CATHODE INCORRECTLY
MARKED ON PCB DECAL!

ChargeCurrent () CMD SETS ACTUAL CHARGE CURRENT.

TO/FROM PIC MCU

SMBus serial comm req'd
to setup, control & monitor
MAX1647 device
INT, an open-drain output

PANEL PC HIGH-SIDE PWR CONTROL

GND
VOLTAGE REGULATOR CIRCUITS PANEL PC POWER

INTERFACE BRD HIGH-SIDE PWR CONTROL

PIC MCU LDO REGULATOR
IN: ___Vnom, OUT: 5V @ 0.1A

PIC active on power
switch activation or
presence of charger power

COMP external network
optional for extended temp
operational requirement

7/15/2024 8:47 PM f=0.24 D:\eSpark-Consultants\eyadkishawi-powerinterface\Client_Files\1700-0003_PowerBoard_RevA_071323\1700-0003_PowerBoard_REV-A.sch (Sheet: 1/2)

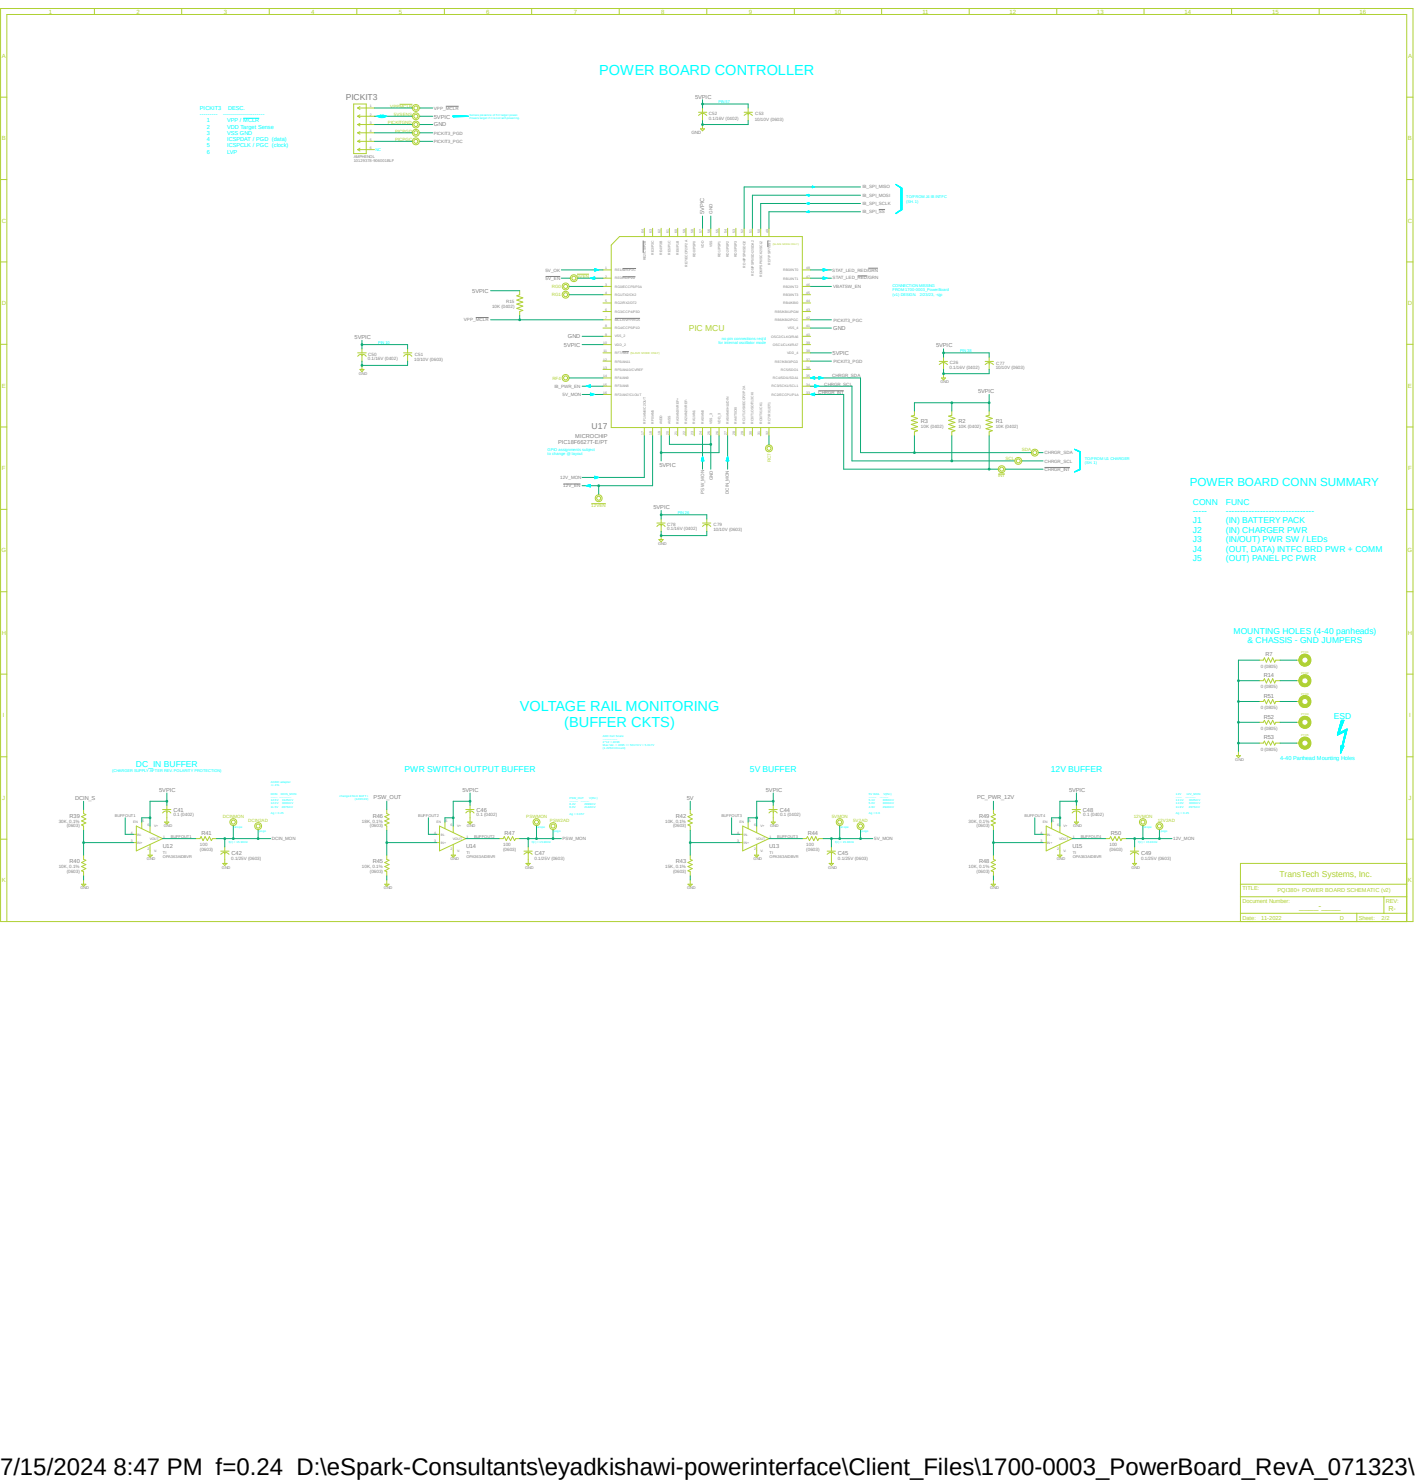
[picture p20: page 2]

Senses presence of 5V target power.
Powers target if it is not self-powering.

TO/FROM J4 IB INTFC

no pin connections req'd
for internal oscillator mode

POWER BOARD CONN SUMMARY

FUNC
(IN) BATTERY PACK
(IN) CHARGER PWR
(IN/OUT) PWR SW / LEDs
(OUT, DATA) INTFC BRD PWR + COMM
(OUT) PANEL PC PWR

7/15/2024 8:47 PM f=0.24 D:\eSpark-Consultants\eyadkishawi-powerinterface\Client_Files\1700-0003_PowerBoard_RevA_071323\1700-0003_PowerBoard_REV-A.sch (Sheet: 2/2)
