eSpark-Backup/eyadkishawi-powerinterface/Client_Files/1700-0003_PowerBoard_RevA_071323/Imported 1700-0003_PowerBoard_REV-A.PrjPcb/1700-0003_PowerBoard_REV-A.pdf

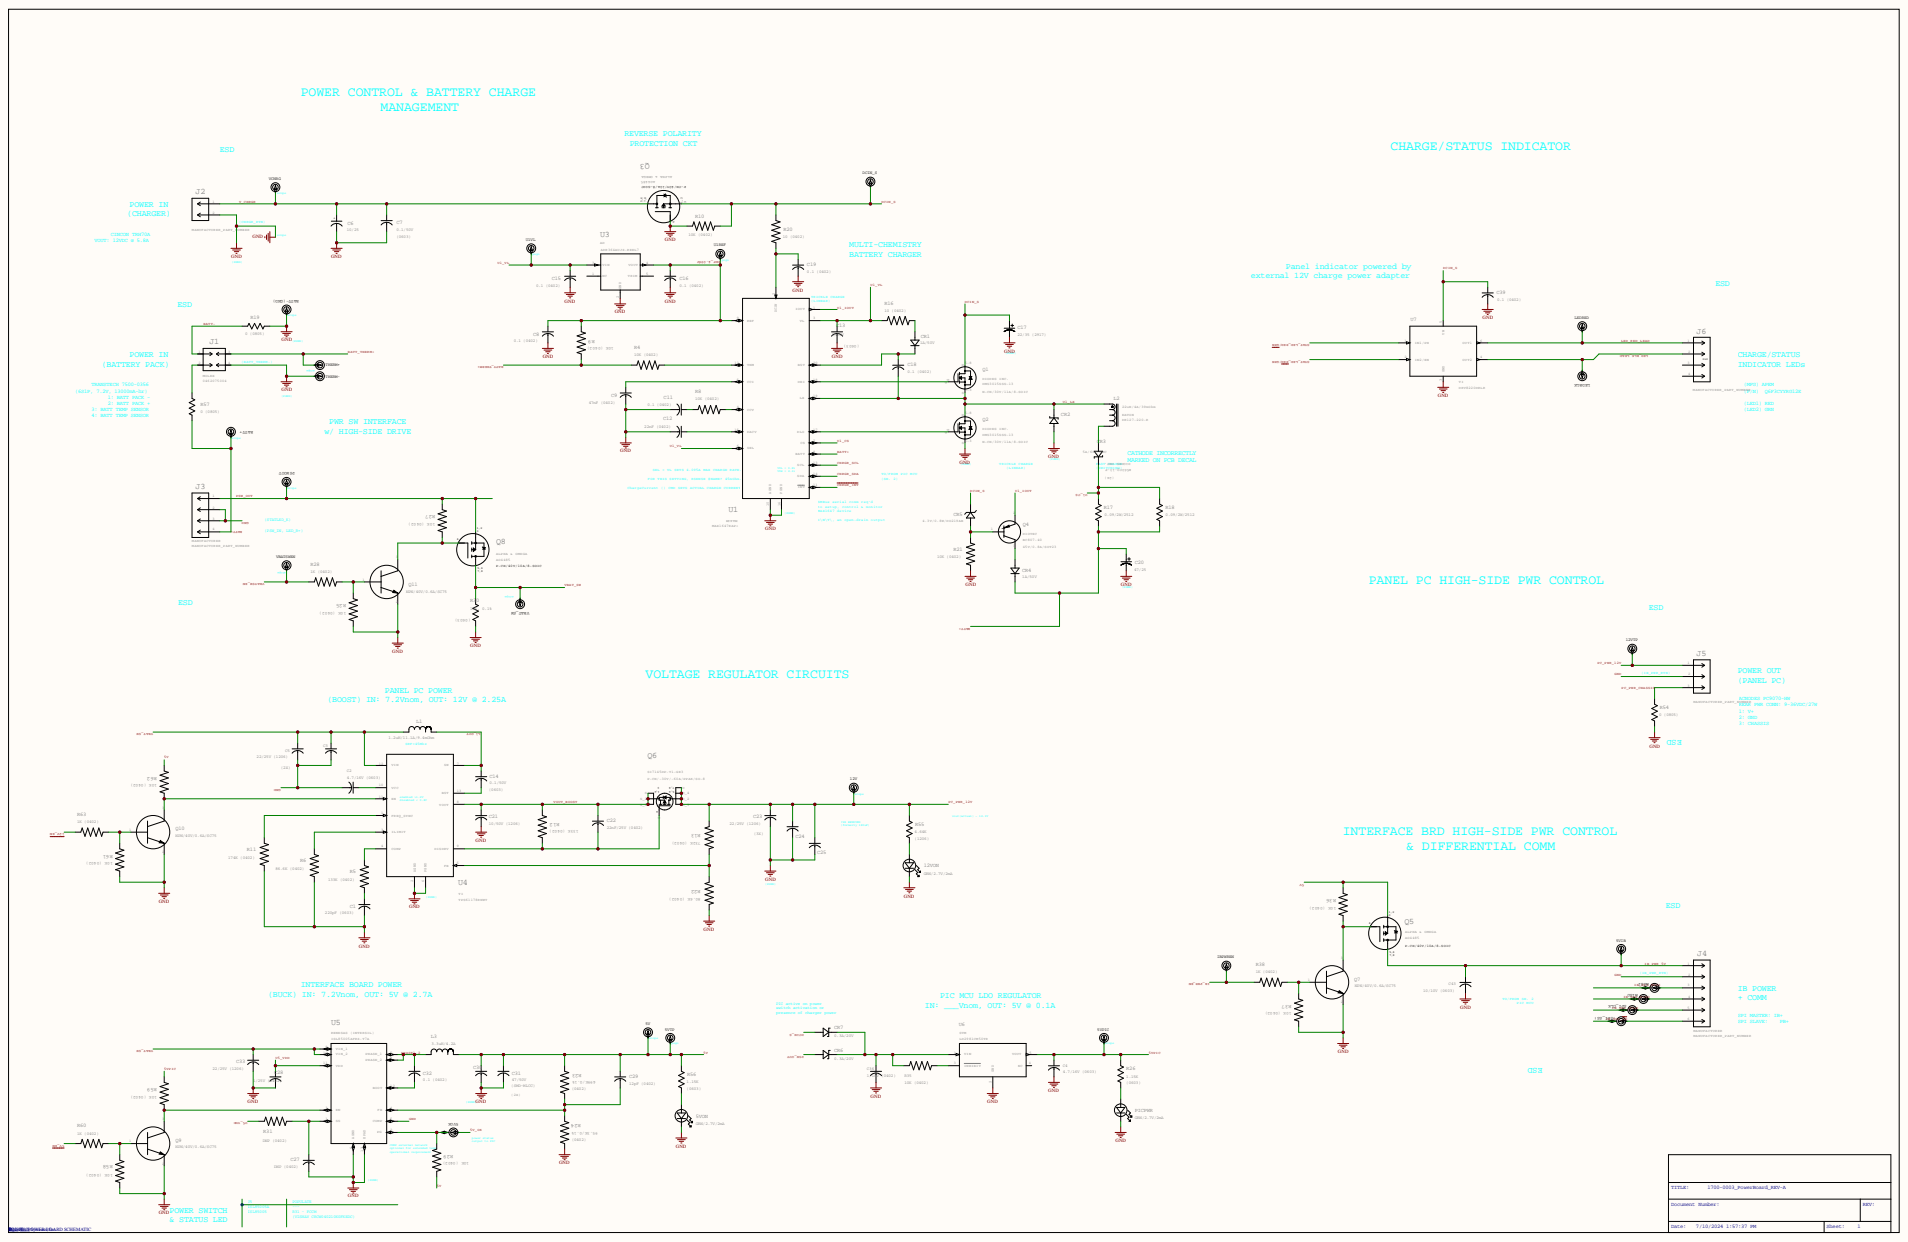
[picture p21: page 1]

POWER CONTROL & BATTERY CHARGE

PANEL PC HIGH-SIDE PWR CONTROL

INTERFACE BRD HIGH-SIDE PWR CONTROL

COMP external network
optional for extended temp
operational requirement

D o c um e n t Numb e r : | R E V :

T4/ ____- RPDQr-22/ aIns380+ 2022 T____ ec Ph SOysWteEmR

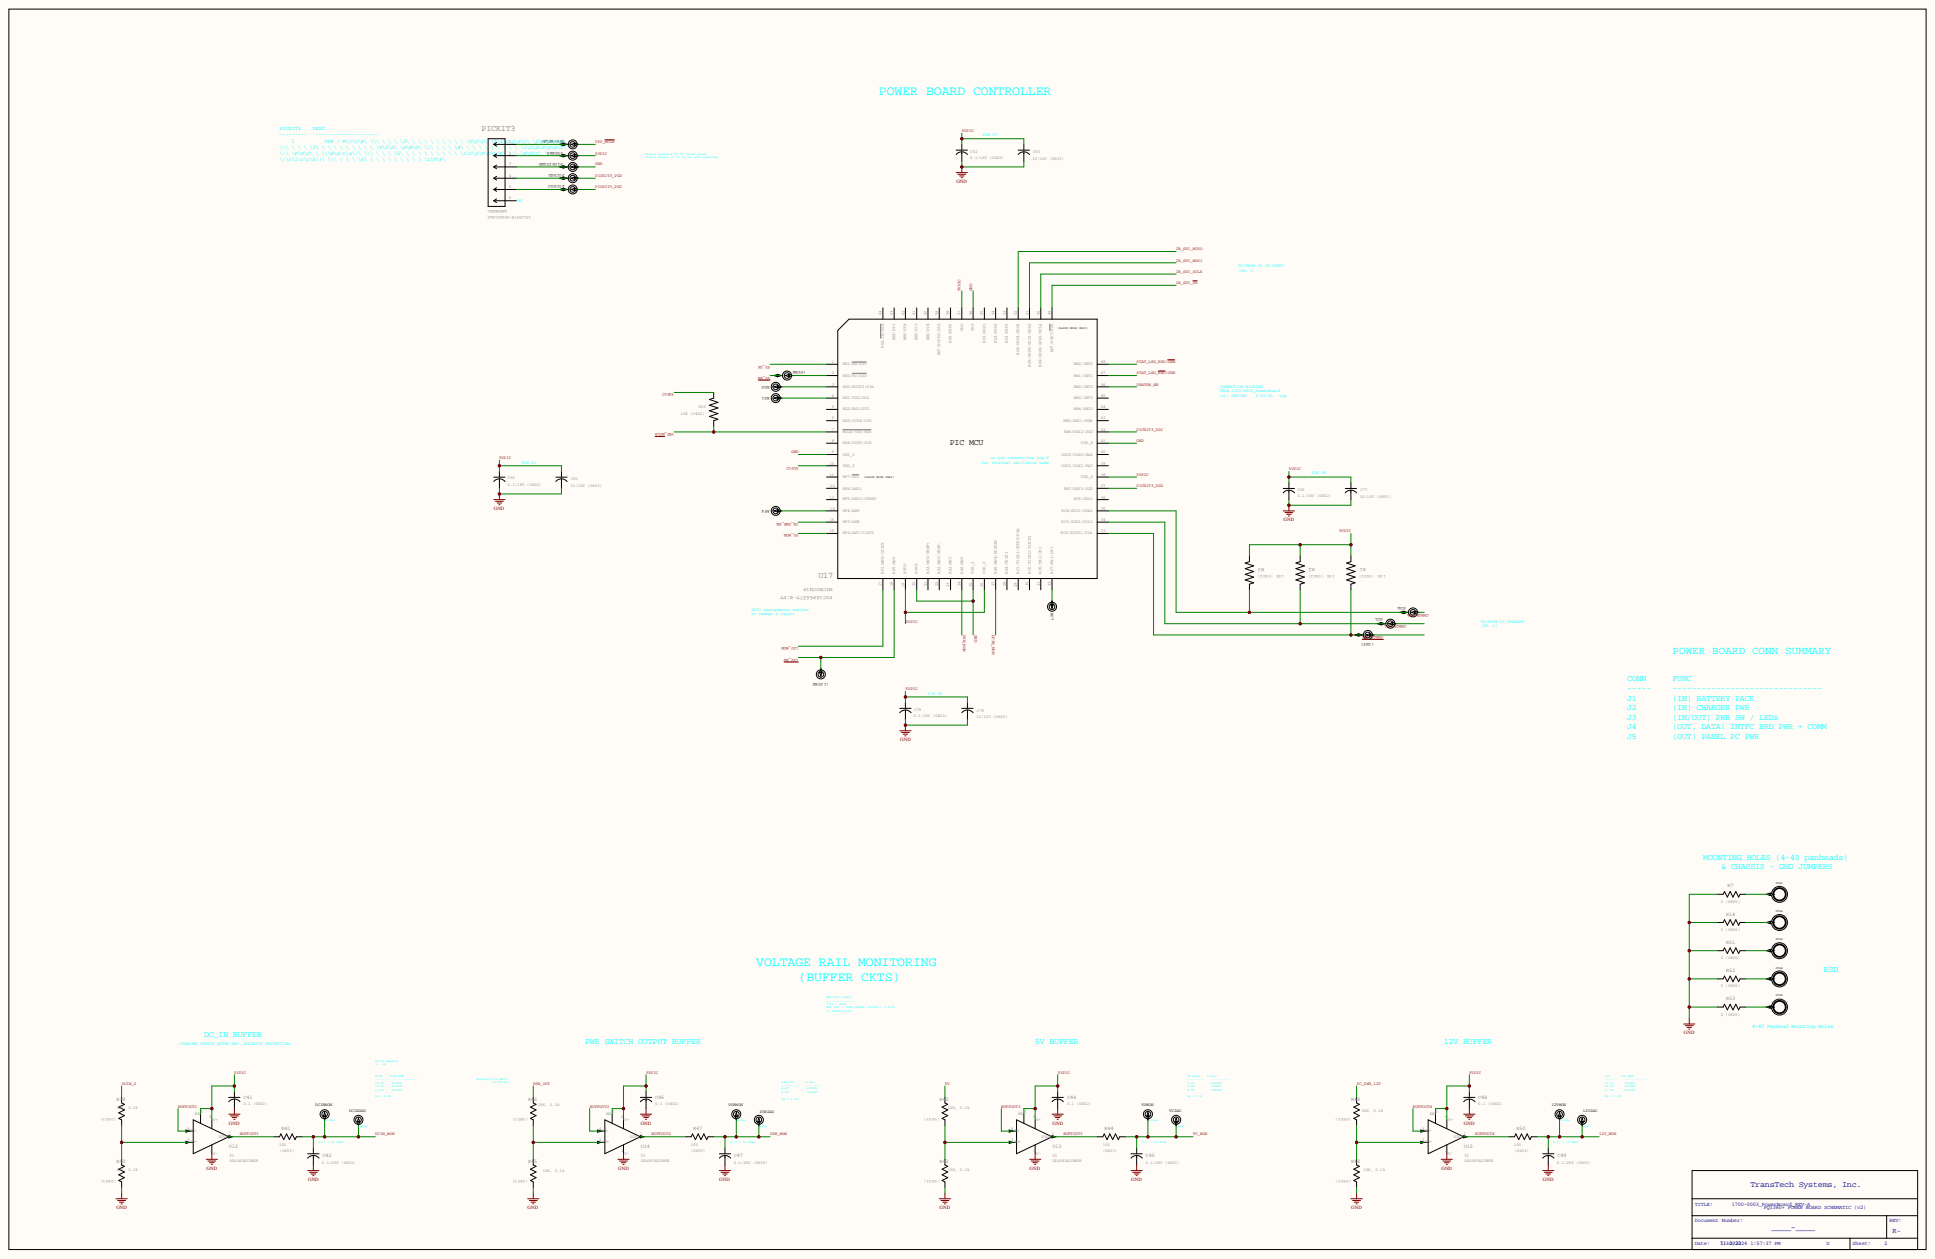
[picture p22: page 2]

Senses presence of 5V target power.
Powers target if it is not self-powering.

TO/FROM J4 IB INTFC

no pin connections req'd
for internal oscillator mode

TO/FROM U1 CHARGER (SH. 1)

POWER BOARD CONN SUMMARY

FUNC
(IN) BATTERY PACK
(IN) CHARGER PWR
(IN/OUT) PWR SW / LEDs
(OUT, DATA) INTFC BRD PWR + COMM
(OUT) PANEL PC PWR

Document Number: ____-____ | REV: R-

Date: 7/10/2024 1:57:37 PM 11-2022 D | Sheet: 2
