eSpark-Backup/eyadkishawi-powerinterface/Design Files/Power_Board/Schematics/Assembly_Drawing.pdf

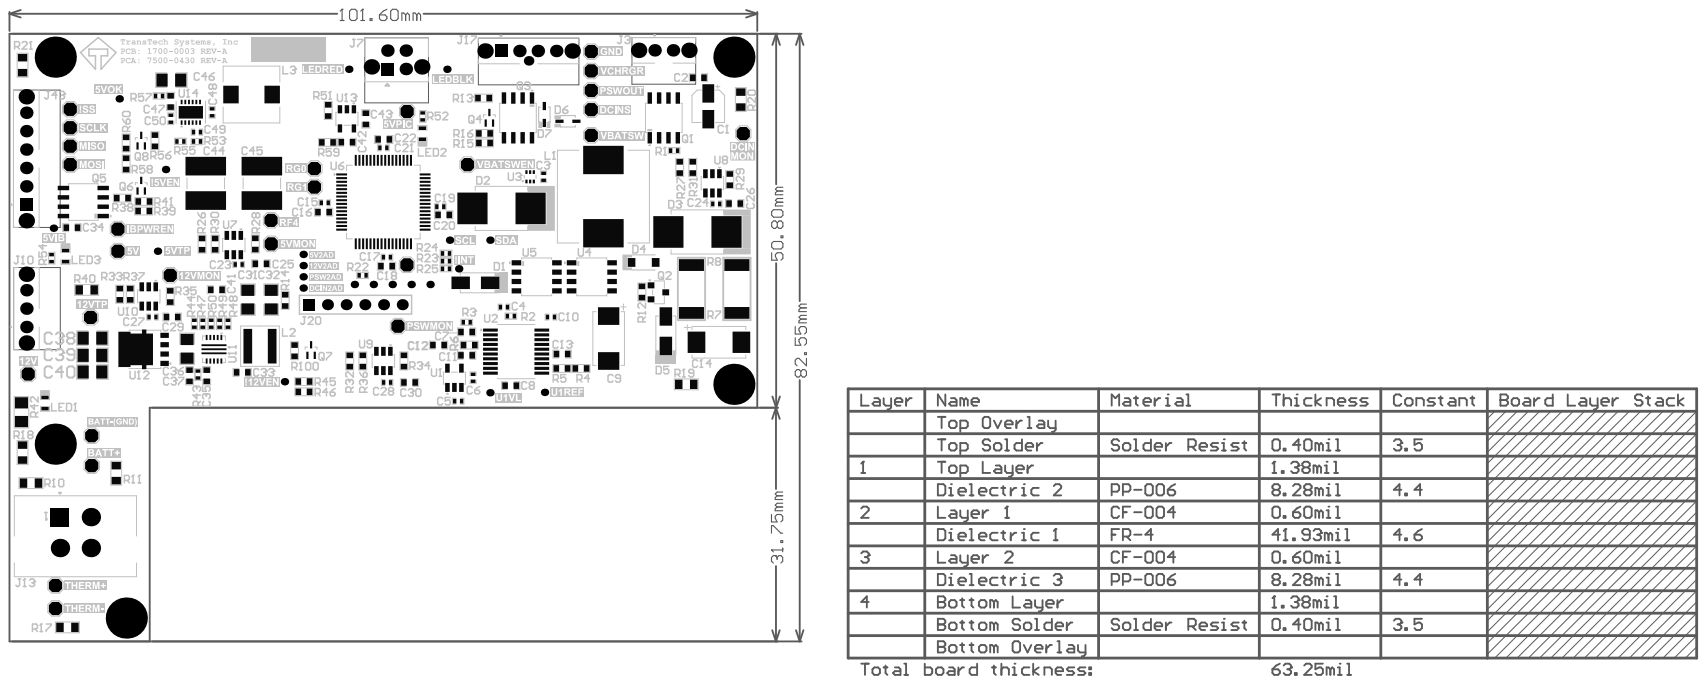
[picture p23: page 1]

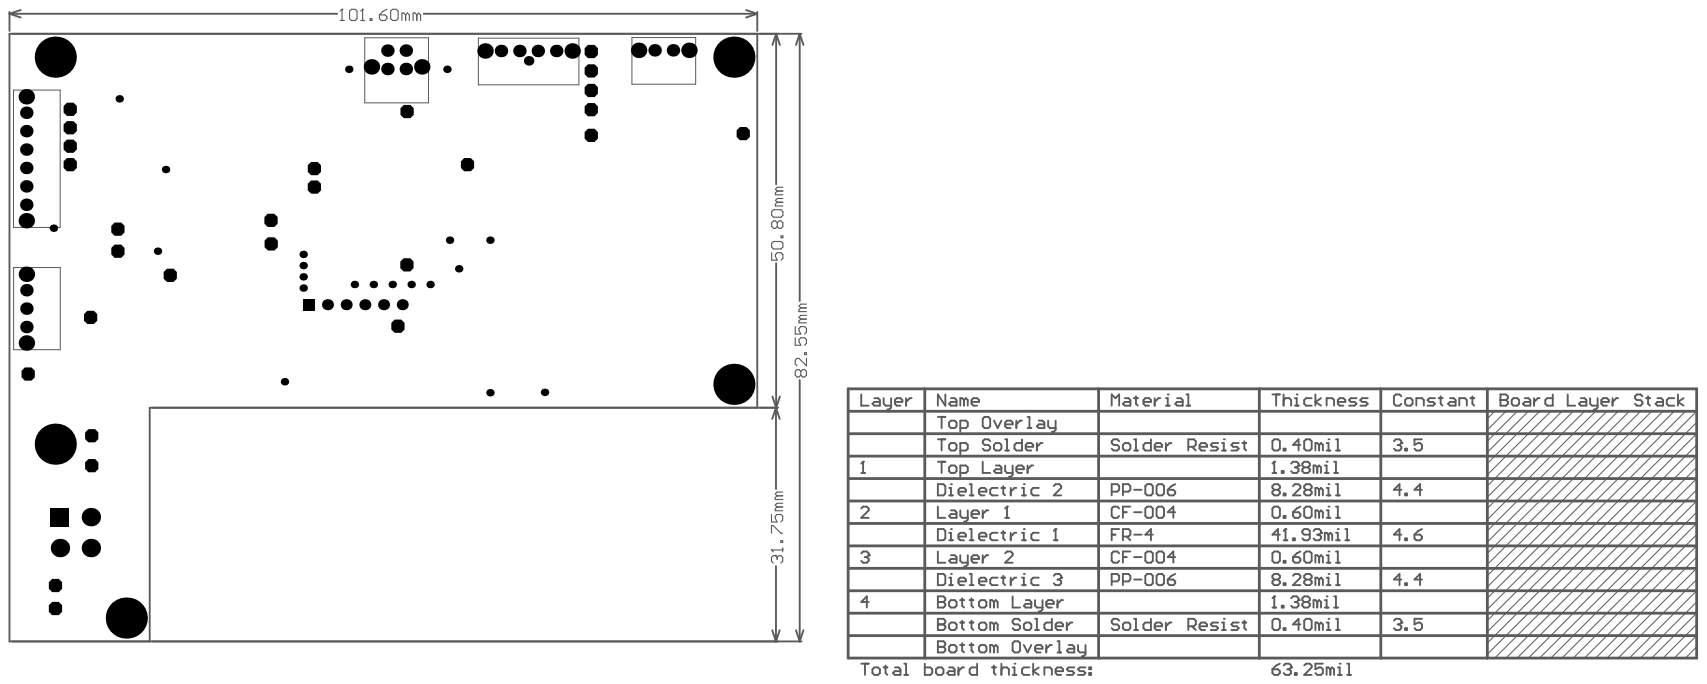
[picture p24: page 2]

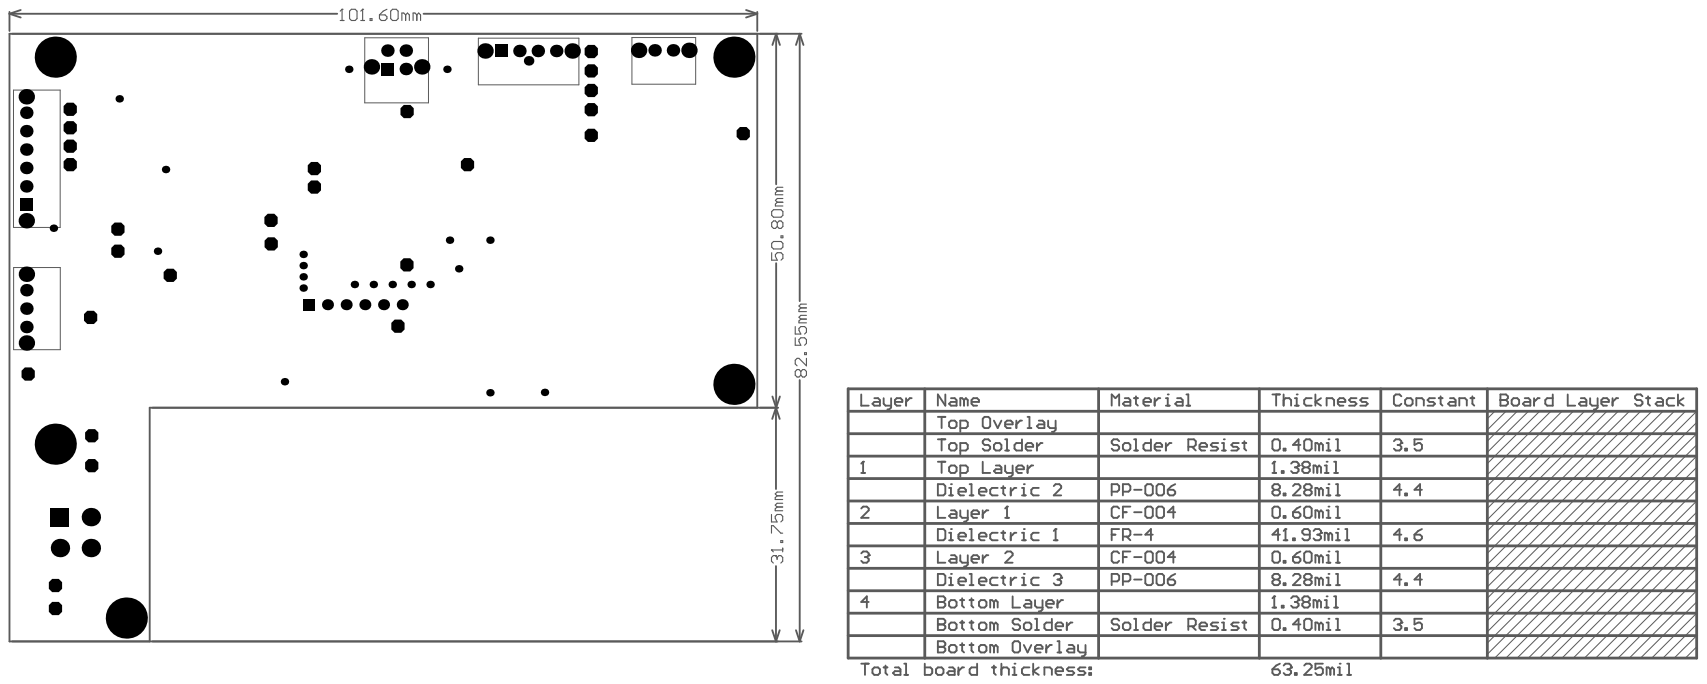
[picture p25: page 4]
