eSpark-Backup/eyadkishawi-powerinterface/(list of files, drawings)

Other design files:
Client_Files/1700-0003_PowerBoard_RevA_071323/Imported 1700-0003_PowerBoard_REV-A.PrjPcb/1700-0003_PowerBoard_REV-A.PcbDoc
Client_Files/1700-0003_PowerBoard_RevA_071323/Imported 1700-0003_PowerBoard_REV-A.PrjPcb/1700-0003_PowerBoard_REV-A.PrjPcb
Client_Files/1700-0003_PowerBoard_RevA_071323/Imported 1700-0003_PowerBoard_REV-A.PrjPcb/1700-0003_PowerBoard_REV-A_0.SchDoc
Client_Files/1700-0003_PowerBoard_RevA_071323/Imported 1700-0003_PowerBoard_REV-A.PrjPcb/1700-0003_PowerBoard_REV-A_1.SchDoc
Design Files/Power_Board/Controller_Sheet.SchDoc
Design Files/Power_Board/PCB_PowerBoard_7500-0430.PcbDoc
Design Files/Power_Board/Power_Sheet.SchDoc
Design Files/Power_Board/PowerBoard_7500-0430.PrjPcb
Design Files/Power_Board/Regulator_Sheet.SchDoc
Design Files/Power_Board/Top_Sheet.SchDoc
