eSpark-Backup/eyadkishawi-powerinterface/Client_Files/1700-0003_PowerBoard_RevA_071323/1700-0003_PowerBoard_REV-A.brd

## EAGLE design Client_Files/1700-0003_PowerBoard_RevA_071323/1700-0003_PowerBoard_REV-A.brd (2024-07-18)

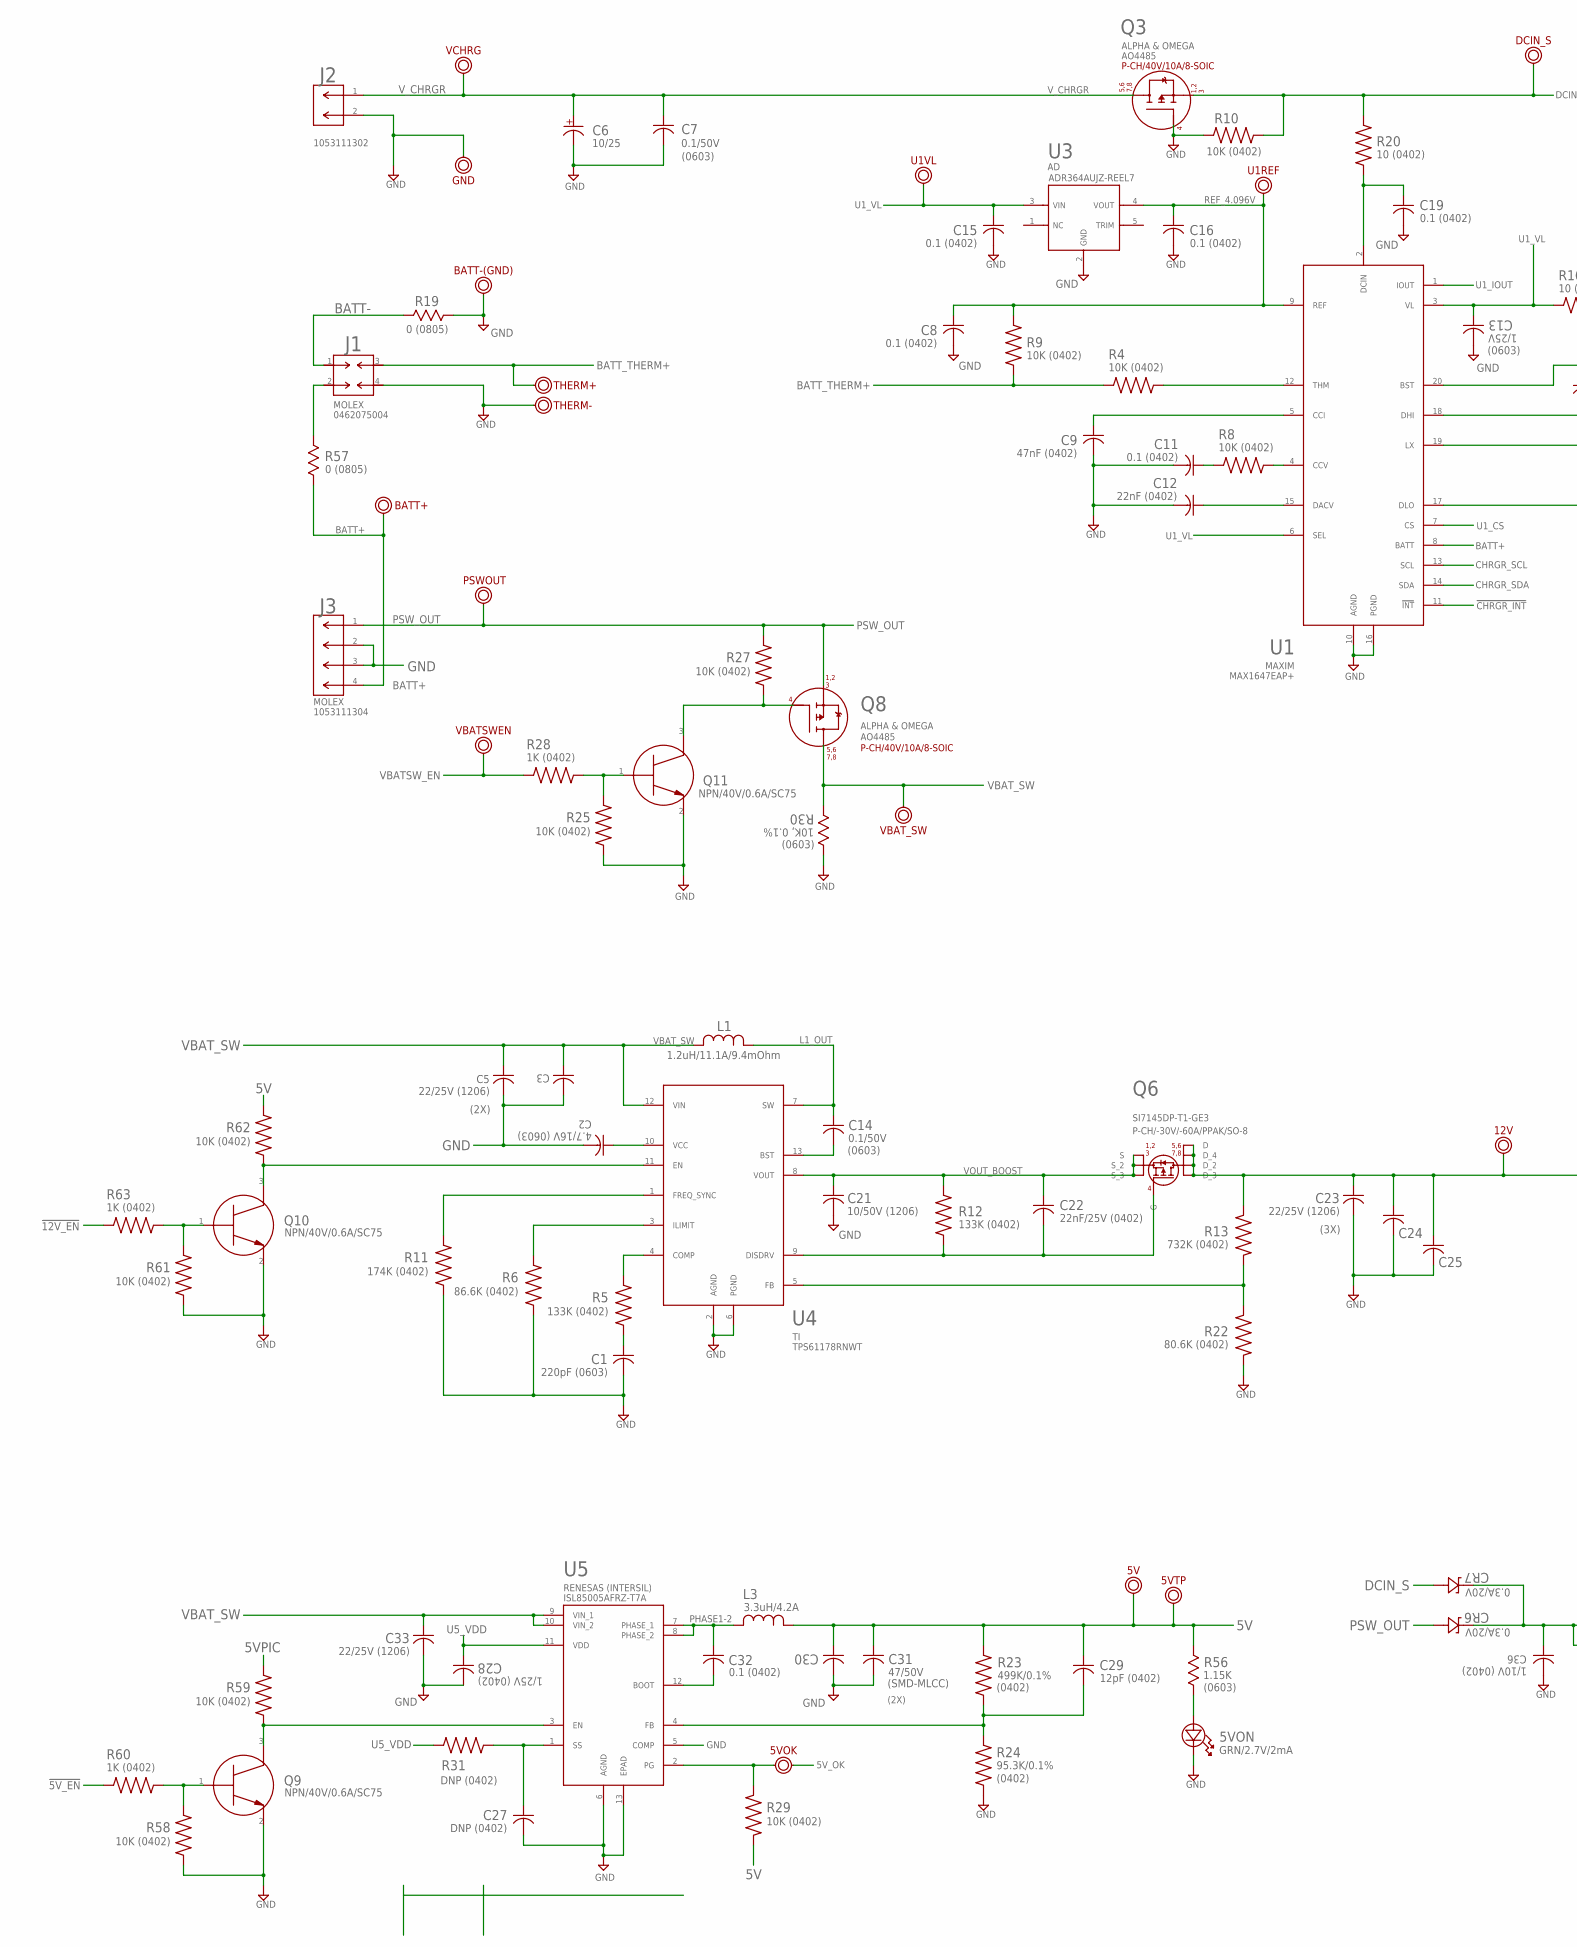
[picture p26: schematic 1700-0003_PowerBoard_REV-A.sch, sheet 1, part in row 1, column 1]

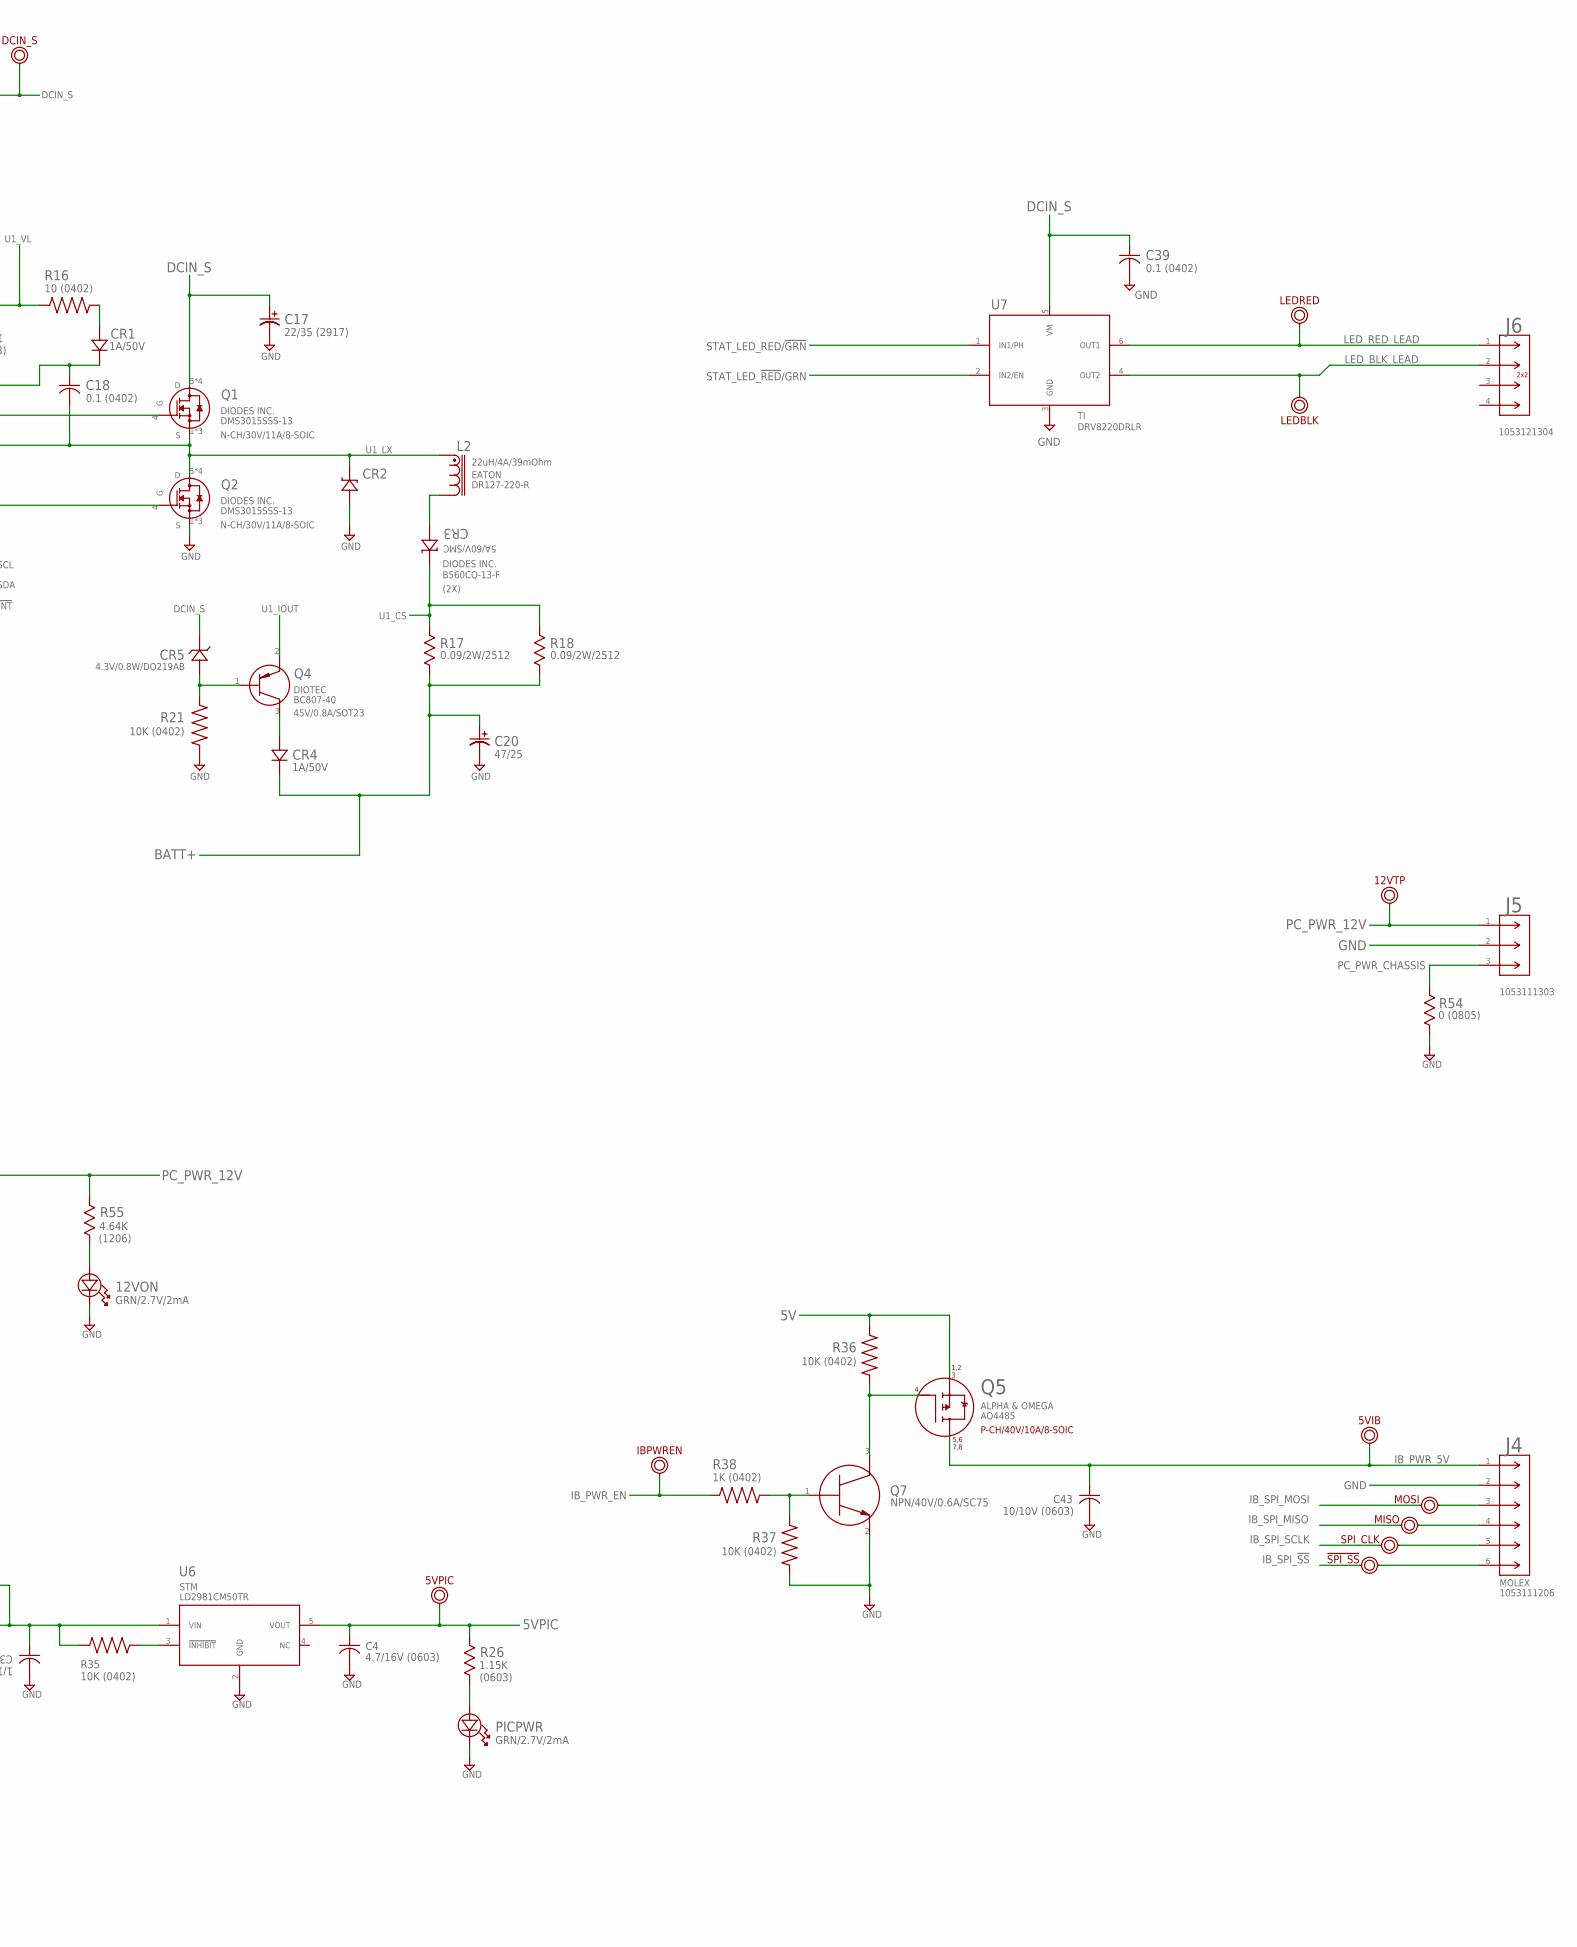
[picture p27: schematic 1700-0003_PowerBoard_REV-A.sch, sheet 1, part in row 1, column 2]

Parts:
5V, 5VPIC, 12V: TST_POINT_PTH_042-OCT
5VIB, 5VTP, 12VTP: TST_POINT_PTH_20X40MIL
5VOK: TST_POINT_PTH_20X40MIL_2PIN
5VON, 12VON: GRN/2.7V/2mA; LED_DIALIGHT_598_DIA
!SPI_SS!: TST_POINT_PTH_042_2PIN; TST_POINT_PTH_042-OCT_2PIN; PART_DESC PCB feature, test point, ID 42mil, OD 7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
BATT+: TST_POINT_PTH_042-OCT
BATT-(GND): TST_POINT_PTH_042-OCT
C1: 220pF (0603); CAP_C1608_TDK; MANUFACTURER_PART_NUMBER CL10C221JB8NNNC
C2, C4: 4.7/16V (0603); CAP_C1608_TDK; MANUFACTURER_PART_NUMBER GRM188Z71C475KE21D
C3, C5, C33: 22/25V (1206); CAP_CL31_SAM
C6: 10/25; CAP_AFK106M25B12T-F_CND-L
C7, C14: 0.1/50V; CAP_C1608_TDK; MANUFACTURER_PART_NUMBER CL10B104KB8NNNC
C8, C11, C15, C16, C18, C19, C32, C39: 0.1 (0402); G-155_MUR
C9: 47nF (0402); G-155_MUR; MANUFACTURER_PART_NUMBER C0402C473K3REC7867
C12: 22nF (0402); G-155_MUR; MANUFACTURER_PART_NUMBER C0402C223K5REC7411
C13: 1/25V; CAP_C1608_TDK; MANUFACTURER_PART_NUMBER CL10B105KA8NNNC
C17: 22/35 (2917); CAPMP7.6X4.3_3.1N_KEM
C20: 47/25; CAPMP7.6X4.3_3.1N_KEM
C21: 10/50V (1206); CAP_CL31_SAM; MANUFACTURER_PART_NUMBER CL31B106KBHNNNE
C22: 22nF/25V (0402); G-155_MUR; MANUFACTURER_PART_NUMBER GRM155R71E223KA61D
C23, C24, C25: 22/25V (1206); CAP_CL31_SAM; MANUFACTURER_PART_NUMBER GCM31CC81E226KE11L
C27: DNP (0402); G-155_MUR; PART_DESC --- DO NOT POPULATE ---
C28: 1/25V (0402); G-155_MUR; MANUFACTURER_PART_NUMBER GRM155R61E105KA12D
C29: 12pF (0402); G-155_MUR; MANUFACTURER_PART_NUMBER C0402C120K5RAC7867
C30: 47/50V (MLCC-SMD); CAP_CKG57N_TDK
C31: 47/50V; CAP_CKG57N_TDK
C36: 1/10V (0402); G-155_MUR; MANUFACTURER_PART_NUMBER GRM155C81C225ME15D
C43: 10/10V (0603); CAP_C1608_TDK; MANUFACTURER_PART_NUMBER GRM188D71A106KA73D
CR1, CR4: 1A/50V; SMA_DIO
CR2, CR3: 5A/60V/SMC; CR_0CQ-13-F_DIO
CR5: 4.3V/0.8W/DO219AB; DIO_BZD27C4V3P_VIS
CR6, CR7: 0.3A/20V; USC_TOS
DCIN_S: TST_POINT_PTH_042-OCT
GND: TST_POINT_PTH_042-OCT
IBPWREN: TST_POINT_PTH_042-OCT
J1: MOLEX_MINI-FIT-JR_462075004; MOLEX_462075004
J2: MOLEX_NANO-FIT_1053111302; CON_1053111302_MOL
J3: MOLEX_NANO-FIT_1053111304; CON_1053111304_MOL
J4: MOLEX_1053111206; CON_1053111206_MOL
J5: MOLEX_NANO-FIT_1053111303; CON_1053111303_MOL
J6: CON_MOLEX_NANOFIT_1053121304; CON_1053121304
L1: 1.2uH/11.1A/9.4mOhm; IND_XAL50XX_COC
L2: 22uH/4A/39mOhm; DR127
L3: 3.3uH/4.2A; IND_CB_DRA74
LEDBLK: TST_POINT_PTH_20X40MIL
LEDRED: TST_POINT_PTH_20X40MIL
MISO: TST_POINT_PTH_042_2PIN; TST_POINT_PTH_042-OCT_2PIN; PART_DESC PCB feature, test point, ID 42mil, OD 7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
MOSI: TST_POINT_PTH_042_2PIN; TST_POINT_PTH_042-OCT_2PIN; PART_DESC PCB feature, test point, ID 42mil, OD 7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
PICPWR: GRN/2.7V/2mA; LED_DIALIGHT_598_DIA
PSWOUT: TST_POINT_PTH_042-OCT
Q1, Q2: N-CH/30V/11A/8-SOIC; SOIC127P600X175-8N
Q3, Q5, Q8: P-CH/40V/10A/8-SOIC; SOIC127P600X175-8N
Q4: 45V/0.8A/SOT23; SOT-23-3_DIOTEC
Q6: P-CH/-30V/-60A/PPAK/SO-8; SON8_SI7135DP-T1-GE3_VIS
Q7, Q9, Q10, Q11: NPN/40V/0.6A/SC75; SC-75(SOT-416)_ONSEMI
R4, R8, R9, R10, R21, R25, R27, R29, R35, R36, R37, R58, R59, R61, R62: 10K (0402); RESC1005X35N
R5: 133K (0402); RESC1005X35N; MANUFACTURER_PART_NUMBER RMCF0402FT133K
R6: 86.6K (0402); RESC1005X35N; MANUFACTURER_PART_NUMBER CPF0402B86K6E1
R11: 174K (0402); RESC1005X35N; MANUFACTURER_PART_NUMBER CRCW0402174KFKTD
R12: 133K (0402); RESC1005X35N; MANUFACTURER_PART_NUMBER RC0402FR-07178KL
R13: 732K (0402); RESC1005X35N; MANUFACTURER_PART_NUMBER CRCW0402732KFKED
R16, R20: 10 (0402); RESC1005X35N; MANUFACTURER_PART_NUMBER CRCW040210R0FKEDC
R17, R18: 0.09/2W/2512; RES_2512_TECONN
R19, R54, R57: 0 (0805); STA_HCJ0805_STP
R22: 80.6K (0402); RESC1005X35N; MANUFACTURER_PART_NUMBER CRCW040280K6FKED
R23: 499K/0.1%; RESC1005X35N; MANUFACTURER_PART_NUMBER MCS0402MD4993BE000
R24: 95.3K/0.1%; RESC1005X35N; MANUFACTURER_PART_NUMBER TNPW040295K3BEED
R26, R56: 1.15K; STA_RMCF0603_STP; MANUFACTURER_PART_NUMBER RMCF0603FT1K15
R28, R38, R60, R63: 1K (0402); RESC1005X35N; MANUFACTURER_PART_NUMBER CRCW04021K00FKEDC
R30: 10K, 0.1%; STA_RMCF0603_STP; MANUFACTURER_PART_NUMBER RNCS0603BKE10K0
R31: DNP (0402); RESC1005X35N; MANUFACTURER_PART_NUMBER ---
R55: 4.64K; RC1206N_YAG; MANUFACTURER_PART_NUMBER CRCW12064K64FKEAC
SPI_CLK: TST_POINT_PTH_042_2PIN; TST_POINT_PTH_042-OCT_2PIN; PART_DESC PCB feature, test point, ID 42mil, OD 7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
THERM+: TST_POINT_PTH_042-OCT
THERM-: TST_POINT_PTH_042-OCT
U1: MAX1647EAP+; 21-0056C_20_MXM; PART_DESC IC BATT CHG MULTI-CHEM 20SSOP
U1REF, U1VL: TST_POINT_PTH_20X40MIL
U3: AD_REFERENCE_ADR364AUJZ-REEL7; UJ_5_ADI
U4: REGULATOR_BOOST_TI_TPS61178RNWT; RNW0013A
U5: REGULATOR_BUCK_RENESAS_ISL85005AFRZ-T7A; SON50P300X400X90-13N; PART_DESC Buck Switching Regulator IC Positive Ad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
U6: IC_LDO_STM_LD2981CM50TR; SOT23-5L_STM
U7: IC_H-BRIDGE_TI_DRV8220DRLR; SOT5X3-6_DRL_TEX
VBATSWEN: TST_POINT_PTH_042-OCT
VBAT_SW: TST_POINT_PTH_042-OCT
VCHRG: TST_POINT_PTH_042-OCT; PART_DESC PCB feature, test point, ID 42mil, OD 7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

Connections:
5V: 5V.P$1, 5VTP.P$1, C29.1, C30.1, C31.1, L3.1, Q5.1 (S), Q5.2 (S), Q5.3 (S), R23.1, R29.1, R36.2, R56.2, R62.2; also elsewhere on the board
5VPIC: 5VPIC.P$1, C4.1, R26.2, R59.2, U6.5 (VOUT); also elsewhere on the board
5V_OK: 5VOK.P$1, 5VOK.P$2, R29.2, U5.2 (PG); also elsewhere on the board
!5V_EN!: R60.1; also elsewhere on the board
!12V_EN!: R63.1; also elsewhere on the board
!CHRGR_INT!: U1.11 (!INT); also elsewhere on the board
$N36: C36.1, CR6.1 (K), CR7.1 (K), R35.2, U6.1 (VIN)
$N99: J1.2, R57.2
BATT+: BATT+.P$1, C20.1, CR4.1, J3.4, R17.2, R18.2, R57.1, U1.8 (BATT)
BATT-: J1.1, R19.2
BATT_THERM+: J1.3, R4.1, R9.2, THERM+.P$1
CHRGR_SCL: U1.13 (SCL); also elsewhere on the board
CHRGR_SDA: U1.14 (SDA); also elsewhere on the board
DCIN_S: C17.1, C39.1, CR5.2 (K), CR7.2 (A), DCIN_S.P$1, Q1.5 (D), Q1.6 (D), Q1.7 (D), Q1.8 (D), Q3.1 (S), Q3.2 (S), Q3.3 (S), R10.2, R20.2, U7.5 (VM); also elsewhere on the board
GND: 5VON.1, 12VON.1, BATT-(GND).P$1, C1.2, C2.2, C3.2, C4.2, C5.2, C6.2, C7.2, C8.2, C9.2, C11.2, C12.2, C13.2, C15.2, C16.2, C17.2, C19.2, C20.2, C21.2, C23.2, C24.2, C25.2, C27.2, C28.2, C30.2, C31.2, C33.2, C36.2, C39.2, C43.2, CR2.1 (A), GND.P$1, J1.4, J2.2, J3.2, J3.3, J4.2, J5.2, PICPWR.1, Q2.1 (S), Q2.2 (S), Q2.3 (S), Q3.4 (G), Q7.2 (E), Q9.2 (E), Q10.2 (E), Q11.2 (E), R6.2, R10.1, R11.2, R19.1, R21.2, R22.2, R24.2, R25.1, R30.2, R37.1, R54.2, R58.1, R61.1, THERM-.P$1, U1.10 (AGND), U1.16 (PGND), U3.2 (GND), U4.2 (AGND), U4.6 (PGND), U5.5 (COMP), U5.6 (AGND), U5.13 (EPAD), U6.2 (GND), U7.3 (GND); also elsewhere on the board
IB_PWR_5V: 5VIB.P$1, C43.1, J4.1, Q5.5 (D), Q5.6 (D), Q5.7 (D), Q5.8 (D)
IB_PWR_EN: IBPWREN.P$1, R38.1; also elsewhere on the board
IB_SPI_!SS: !SPI_SS!.P$1, !SPI_SS!.P$2, J4.6; also elsewhere on the board
IB_SPI_MISO: J4.4, MISO.P$1, MISO.P$2; also elsewhere on the board
IB_SPI_MOSI: J4.3, MOSI.P$1, MOSI.P$2; also elsewhere on the board
IB_SPI_SCLK: J4.5, SPI_CLK.P$1, SPI_CLK.P$2; also elsewhere on the board
L1_OUT: C14.1, L1.1, U4.7 (SW)
LED_BLK_LEAD: J6.2, LEDBLK.P$1, U7.4 (OUT2)
LED_RED_LEAD: J6.1, LEDRED.P$1, U7.6 (OUT1)
unnamed: R5.1, U4.4 (COMP)
unnamed: C19.1, R20.1, U1.2 (DCIN)
unnamed: Q1.4 (G), U1.18 (DHI)
unnamed: C1.1, R5.2
unnamed: R4.2, U1.12 (THM)
unnamed: R6.1, U4.3 (ILIMIT)
unnamed: C2.1, U4.10 (VCC)
unnamed: R11.1, U4.1 (FREQ_SYNC)
unnamed: C9.1, U1.5 (CCI)
unnamed: R8.2, U1.4 (CCV)
unnamed: C11.1, R8.1
unnamed: C12.1, U1.15 (DACV)
unnamed: CR4.2, Q4.3 (C)
unnamed: CR1.2, R16.2
unnamed: Q2.4 (G), U1.17 (DLO)
unnamed: C18.1, CR1.1, U1.20 (BST)
unnamed: CR3.1 (A), L2.2
unnamed: C14.2, U4.13 (BST)
unnamed: C22.2, Q6.4 (G), R12.2, U4.9 (DISDRV)
unnamed: CR5.1 (A), Q4.1 (B), R21.1
unnamed: Q8.4 (G), Q11.3 (C), R27.1
unnamed: C27.1, R31.2, U5.1 (SS)
unnamed: R13.2, R22.1, U4.5 (FB)
unnamed: C32.2, U5.12 (BOOT)
unnamed: C29.2, R23.2, R24.1, U5.4 (FB)
unnamed: 5VON.2, R56.1
unnamed: R35.1, U6.3 (!INHIBIT!)
unnamed: Q11.1 (B), R25.2, R28.2
unnamed: Q5.4 (G), Q7.3 (C), R36.1
unnamed: Q7.1 (B), R37.2, R38.2
unnamed: 12VON.2, R55.2
unnamed: PICPWR.2, R26.1
unnamed: Q9.1 (B), R58.2, R60.2
unnamed: Q9.3 (C), R59.1, U5.3 (EN)
unnamed: Q10.3 (C), R62.1, U4.11 (EN)
unnamed: Q10.1 (B), R61.2, R63.2
PC_PWR_12V: 12V.P$1, 12VTP.P$1, C23.1, C24.1, C25.1, J5.1, Q6.5 (D_3), Q6.6 (D_2), Q6.7 (D_4), Q6.8 (D), R13.1, R55.1; also elsewhere on the board
PC_PWR_CHASSIS: J5.3, R54.1
PHASE1-2: C32.1, L3.2, U5.7 (PHASE_1), U5.8 (PHASE_2)
PSW_OUT: CR6.2 (A), J3.1, PSWOUT.P$1, Q8.1 (S), Q8.2 (S), Q8.3 (S), R27.2; also elsewhere on the board
REF_4.096V: C8.1, C16.1, R9.1, U1.9 (REF), U1REF.P$1, U3.4 (VOUT)
STAT_LED_!RED!/GRN: U7.2 (IN2/EN); also elsewhere on the board
STAT_LED_RED/!GRN!: U7.1 (IN1/PH); also elsewhere on the board
U1_CS: CR3.2 (K), R17.1, R18.1, U1.7 (CS)
U1_IOUT: Q4.2 (E), U1.1 (IOUT)
U1_LX: C18.2, CR2.2 (K), L2.1, Q1.1 (S), Q1.2 (S), Q1.3 (S), Q2.5 (D), Q2.6 (D), Q2.7 (D), Q2.8 (D), U1.19 (LX)
U1_VL: C13.1, C15.1, R16.1, U1.3 (VL), U1.6 (SEL), U1VL.P$1, U3.3 (VIN)
U5_VDD: C28.1, R31.1, U5.11 (VDD)
VBATSW_EN: R28.1, VBATSWEN.P$1; also elsewhere on the board
VBAT_SW: C3.1, C5.1, C33.1, L1.2, Q8.5 (D), Q8.6 (D), Q8.7 (D), Q8.8 (D), R30.1, U4.12 (VIN), U5.9 (VIN_1), U5.10 (VIN_2), VBAT_SW.P$1
VOUT_BOOST: C21.1, C22.1, Q6.1 (S_3), Q6.2 (S_2), Q6.3 (S), R12.1, U4.8 (VOUT)
V_CHRGR: C6.1, C7.1, J2.1, Q3.5 (D), Q3.6 (D), Q3.7 (D), Q3.8 (D), VCHRG.P$1

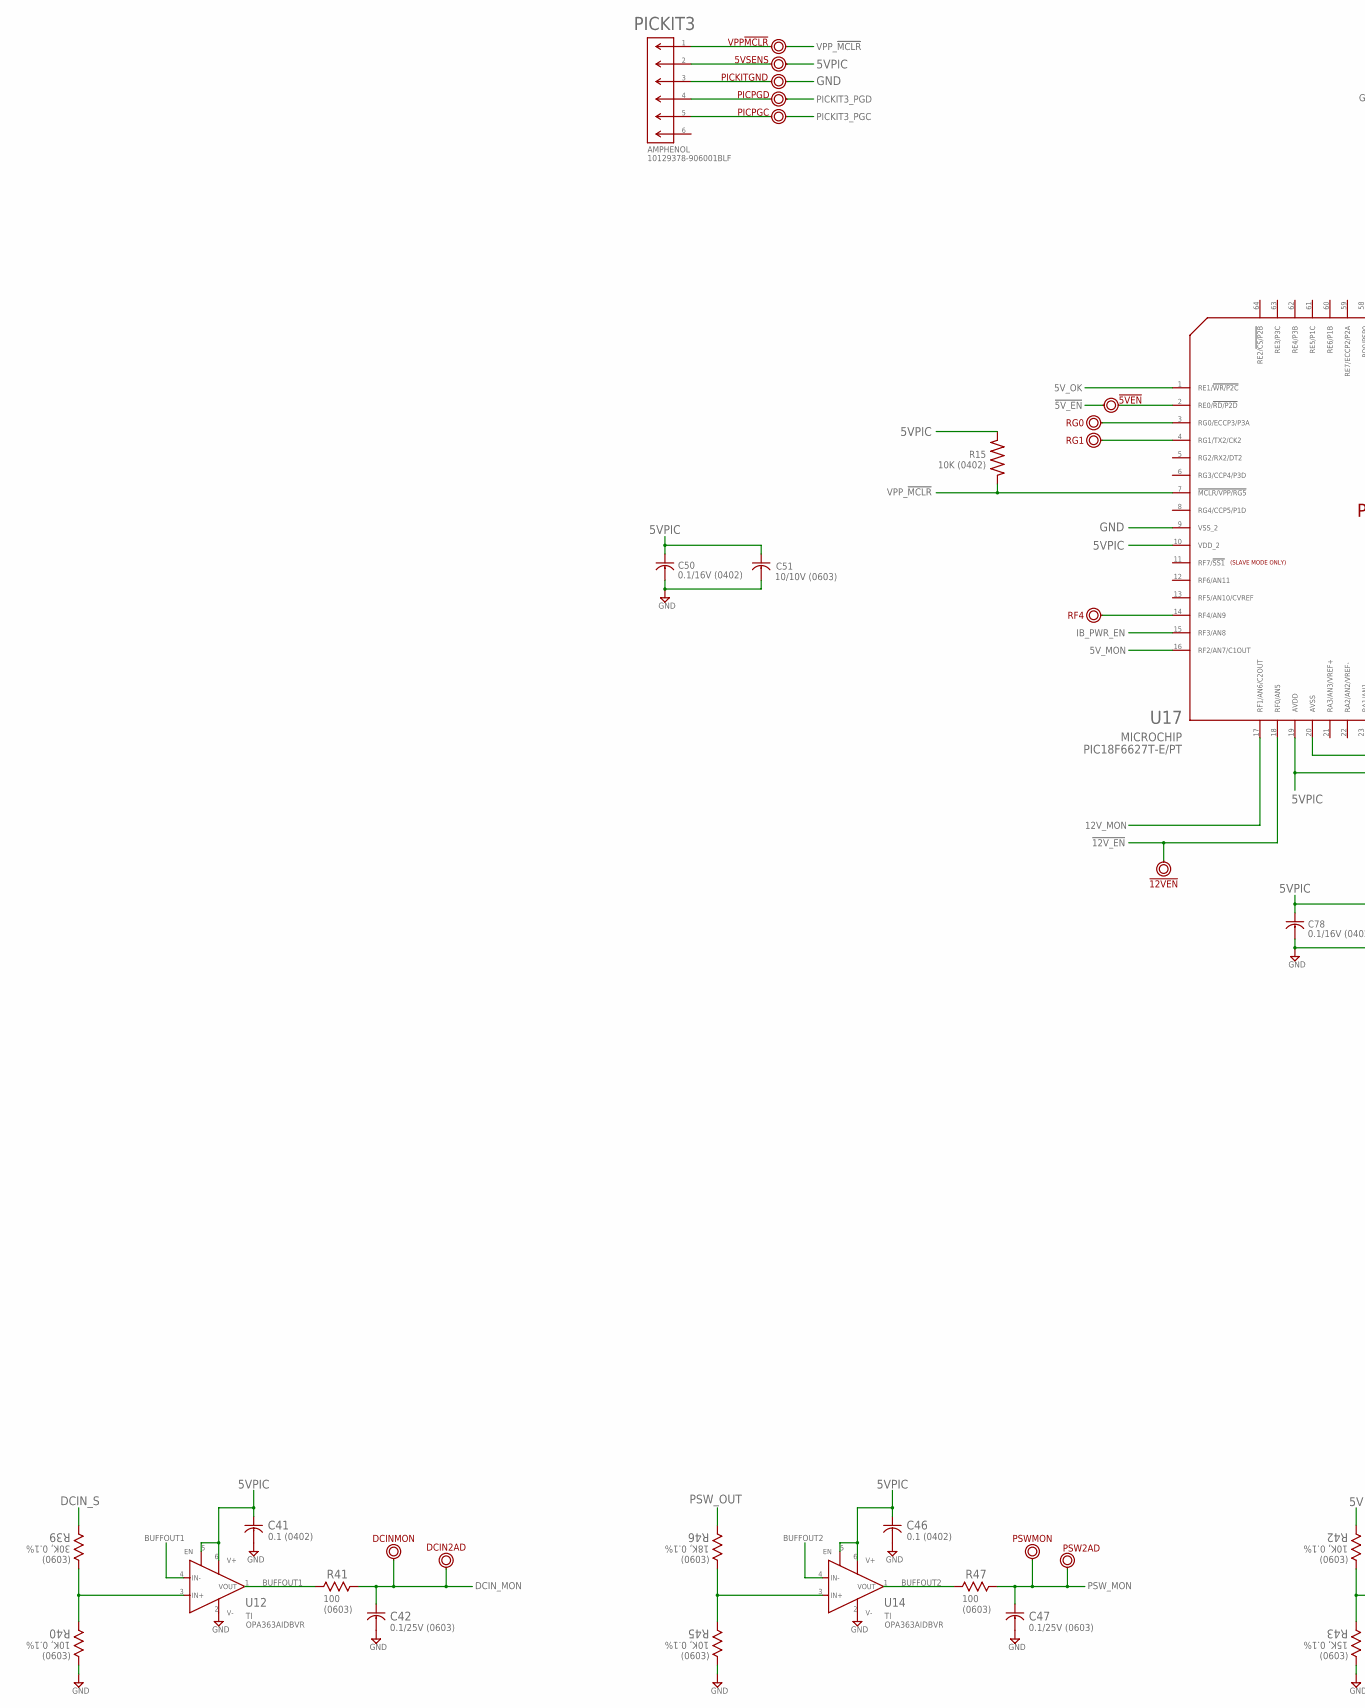
[picture p28: schematic 1700-0003_PowerBoard_REV-A.sch, sheet 2, part in row 1, column 1]

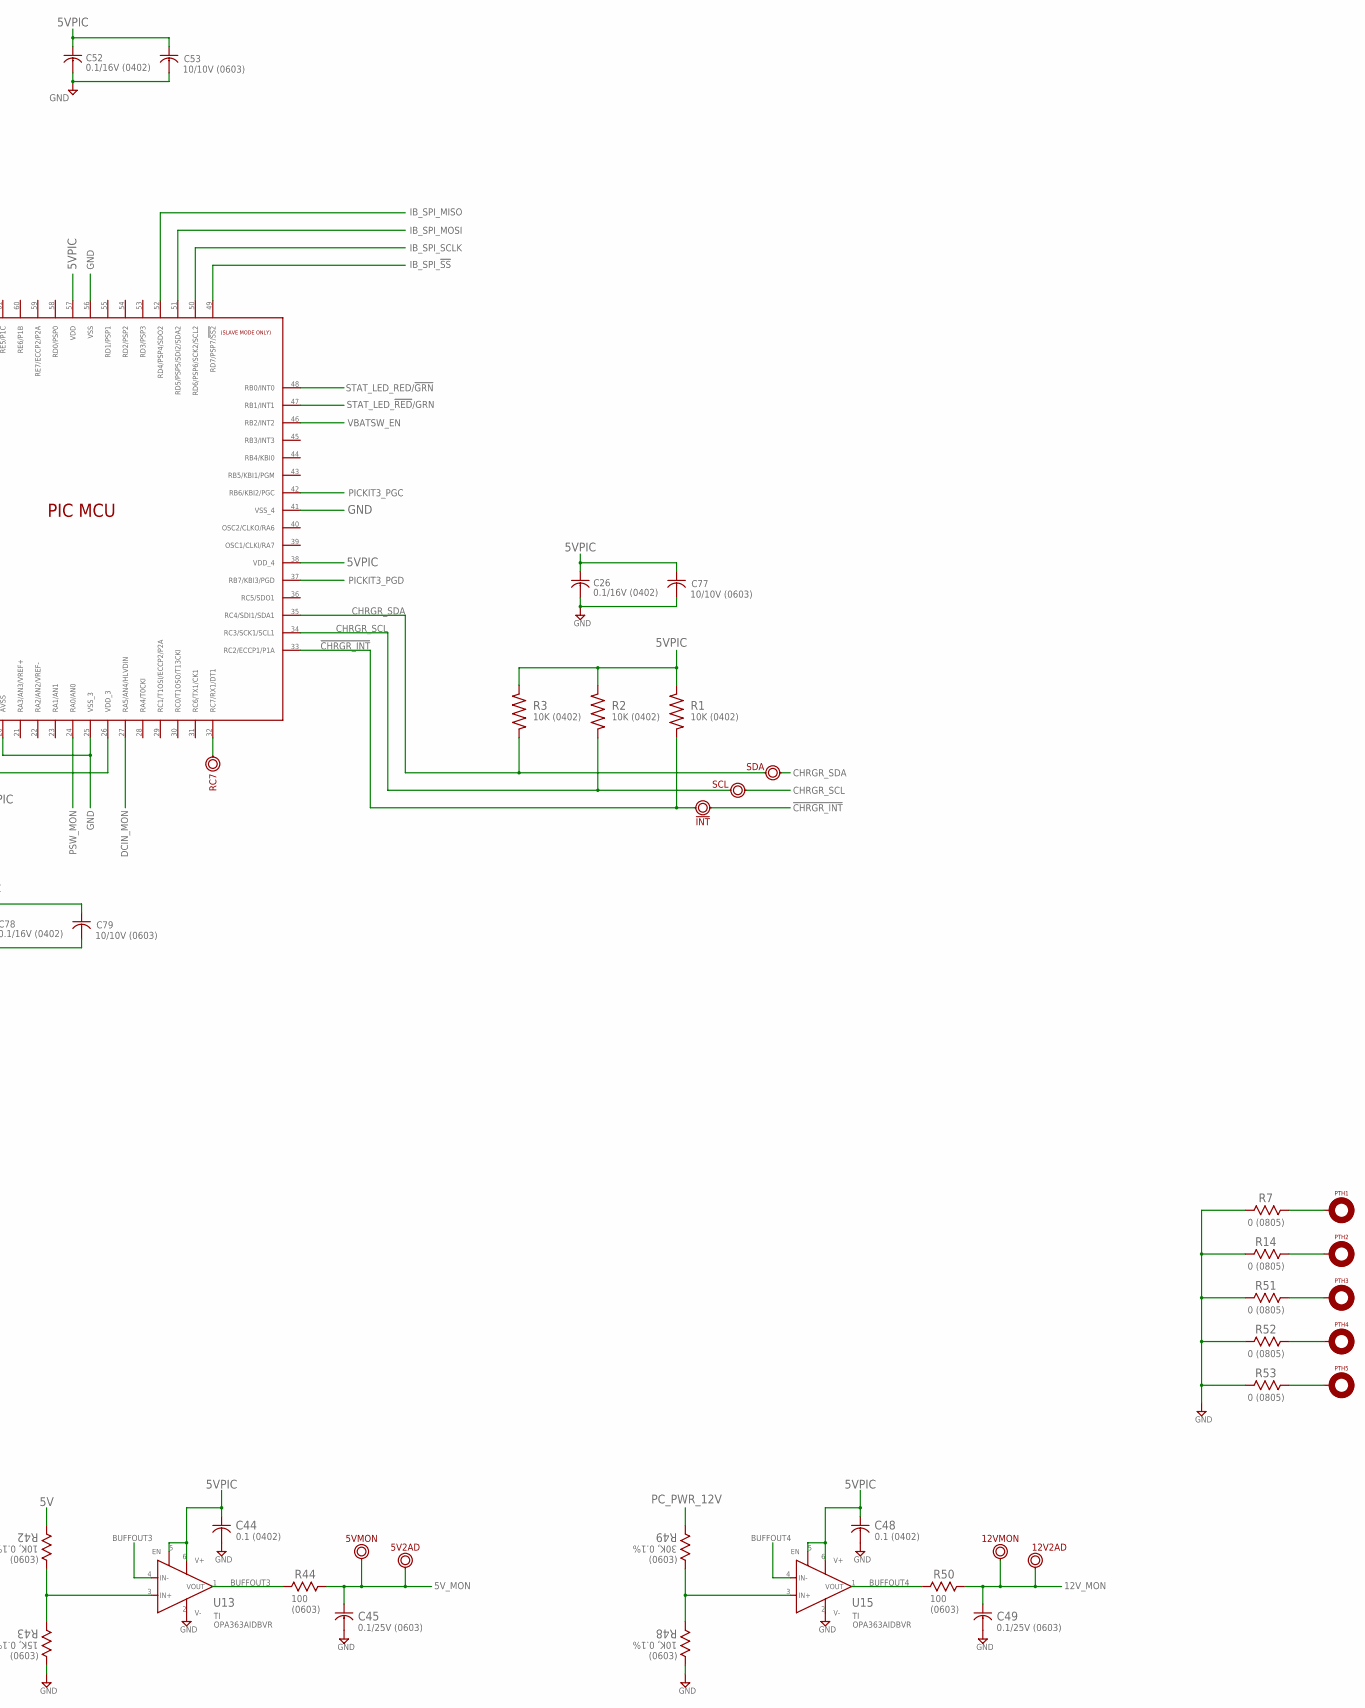
[picture p29: schematic 1700-0003_PowerBoard_REV-A.sch, sheet 2, part in row 1, column 2]

Parts:
5V2AD, 12V2AD: TST_POINT_PTH_20X40MIL
5VMON, 12VMON: TST_POINT_PTH_042-OCT
5VSENS: TST_POINT_PTH_20X40MIL_2PIN
!5VEN: TST_POINT_PTH_20X40MIL_2PIN
!12VEN: TST_POINT_PTH_20X40MIL
!INT!: TST_POINT_PTH_20X40MIL_2PIN
C26, C50, C52, C78: 0.1/16V (0402); G-155_MUR
C41, C44, C46, C48: 0.1 (0402); G-155_MUR
C42, C45, C47, C49: 0.1/25V (0603); CAP_C1608_TDK; MANUFACTURER_PART_NUMBER C0603C104K3RAC7867
C51, C53, C77, C79: 10/10V (0603); CAP_C1608_TDK; MANUFACTURER_PART_NUMBER GRM188D71A106KA73D
DCIN2AD: TST_POINT_PTH_20X40MIL
DCINMON: TST_POINT_PTH_042-OCT
PICKIT3: CON_6POS_VERT-HDR_AMPH_10129378-906001; CON6_1X6_VERT-HDR
PICKITGND: TST_POINT_PTH_20X40MIL_2PIN
PICPGC: TST_POINT_PTH_20X40MIL_2PIN
PICPGD: TST_POINT_PTH_20X40MIL_2PIN
PSW2AD: TST_POINT_PTH_20X40MIL
PSWMON: TST_POINT_PTH_042-OCT
PTH1, PTH2, PTH3, PTH4, PTH5: PTH_4-40
R1, R2, R3, R15: 10K (0402); RESC1005X35N
R7, R14, R51, R52, R53: 0 (0805); STA_HCJ0805_STP
R39, R49: 30K, 0.1%; STA_RMCF0603_STP; MANUFACTURER_PART_NUMBER CPF0603B30KE1
R40, R42, R45, R48: 10K, 0.1%; STA_RMCF0603_STP; MANUFACTURER_PART_NUMBER RNCS0603BKE10K0
R41, R44, R47, R50: 100; STA_RMCF0603_STP; MANUFACTURER_PART_NUMBER CPF0603F100RC1
R43: 15K, 0.1%; STA_RMCF0603_STP; MANUFACTURER_PART_NUMBER CPF0603B15KE1
R46: 18K, 0.1%; STA_RMCF0603_STP; MANUFACTURER_PART_NUMBER CPF0603B18KE1
RC7: TST_POINT_PTH_042-OCT
RF4: TST_POINT_PTH_042-OCT
RG0, RG1: TST_POINT_PTH_042-OCT
SCL: TST_POINT_PTH_20X40MIL_2PIN
SDA: TST_POINT_PTH_20X40MIL_2PIN
U12, U13, U14, U15: IC_OPAMP_TI_OPA363AIDBVR; DBV6
U17: PIC18F6627T-E/PT; TQFP64_10X10MC_MCH
VPP!MCLR!: TST_POINT_PTH_20X40MIL_2PIN

Connections:
5V: R42.1; also elsewhere on the board
5VPIC: 5VSENS.P$1, 5VSENS.P$2, C26.1, C41.1, C44.1, C46.1, C48.1, C50.1, C51.1, C52.1, C53.1, C77.1, C78.1, C79.1, PICKIT3.2, R1.1, R2.1, R3.1, R15.1, U12.5 (EN), U12.6 (V+), U13.5 (EN), U13.6 (V+), U14.5 (EN), U14.6 (V+), U15.5 (EN), U15.6 (V+), U17.10 (VDD_2), U17.19 (AVDD), U17.26 (VDD_3), U17.38 (VDD_4), U17.57 (VDD); also elsewhere on the board
5V_MON: 5V2AD.P$1, 5VMON.P$1, C45.1, R44.2, U17.16 (RF2/AN7/C1OUT)
5V_OK: U17.1 (RE1/!WR/P2C); also elsewhere on the board
12V_MON: 12V2AD.P$1, 12VMON.P$1, C49.1, R50.2, U17.17 (RF1/AN6/C2OUT)
!5V_EN!: !5VEN.P$1, !5VEN.P$2, U17.2 (RE0/!RD/P2D); also elsewhere on the board
!12V_EN!: !12VEN.P$1, U17.18 (RF0/AN5); also elsewhere on the board
!CHRGR_INT!: !INT!.P$2, R1.2, U17.33 (RC2/ECCP1/P1A); also elsewhere on the board
BUFFOUT1: R41.1, U12.1 (VOUT), U12.4 (IN-)
BUFFOUT2: R47.1, U14.1 (VOUT), U14.4 (IN-)
BUFFOUT3: R44.1, U13.1 (VOUT), U13.4 (IN-)
BUFFOUT4: R50.1, U15.1 (VOUT), U15.4 (IN-)
CHRGR_SCL: R2.2, SCL.P$2, U17.34 (RC3/SCK1/SCL1); also elsewhere on the board
CHRGR_SDA: R3.2, SDA.P$2, U17.35 (RC4/SDI1/SDA1); also elsewhere on the board
DCIN_MON: C42.1, DCIN2AD.P$1, DCINMON.P$1, R41.2, U17.27 (RA5/AN4/HLVDIN)
DCIN_S: R39.1; also elsewhere on the board
GND: C26.2, C41.2, C42.2, C44.2, C45.2, C46.2, C47.2, C48.2, C49.2, C50.2, C51.2, C52.2, C53.2, C77.2, C78.2, C79.2, PICKIT3.3, PICKITGND.P$1, PICKITGND.P$2, R7.2, R14.2, R40.2, R43.2, R45.2, R48.2, R51.2, R52.2, R53.2, U12.2 (V-), U13.2 (V-), U14.2 (V-), U15.2 (V-), U17.9 (VSS_2), U17.20 (AVSS), U17.25 (VSS_3), U17.41 (VSS_4), U17.56 (VSS); also elsewhere on the board
IB_PWR_EN: U17.15 (RF3/AN8); also elsewhere on the board
IB_SPI_!SS: U17.49 (RD7/PSP7/!SS2); also elsewhere on the board
IB_SPI_MISO: U17.52 (RD4/PSP4/SDO2); also elsewhere on the board
IB_SPI_MOSI: U17.51 (RD5/PSP5/SDI2/SDA2); also elsewhere on the board
IB_SPI_SCLK: U17.50 (RD6/PSP6/SCK2/SCL2); also elsewhere on the board
unnamed: RG0.P$1, U17.3 (RG0/ECCP3/P3A)
unnamed: RG1.P$1, U17.4 (RG1/TX2/CK2)
unnamed: RF4.P$1, U17.14 (RF4/AN9)
unnamed: R39.2, R40.1, U12.3 (IN+)
unnamed: R42.2, R43.1, U13.3 (IN+)
unnamed: R45.1, R46.2, U14.3 (IN+)
unnamed: R48.1, R49.2, U15.3 (IN+)
unnamed: RC7.P$1, U17.32 (RC7/RX1/DT1)
unnamed: PTH1.P$1, R7.1
unnamed: PTH2.P$1, R14.1
unnamed: PTH3.P$1, R51.1
unnamed: PTH4.P$1, R52.1
unnamed: PTH5.P$1, R53.1
PC_PWR_12V: R49.1; also elsewhere on the board
PICKIT3_PGC: PICKIT3.5, PICPGC.P$1, PICPGC.P$2, U17.42 (RB6/KBI2/PGC)
PICKIT3_PGD: PICKIT3.4, PICPGD.P$1, PICPGD.P$2, U17.37 (RB7/KBI3/PGD)
PSW_MON: C47.1, PSW2AD.P$1, PSWMON.P$1, R47.2, U17.24 (RA0/AN0)
PSW_OUT: R46.1; also elsewhere on the board
STAT_LED_!RED!/GRN: U17.47 (RB1/INT1); also elsewhere on the board
STAT_LED_RED/!GRN!: U17.48 (RB0/INT0); also elsewhere on the board
VBATSW_EN: U17.46 (RB2/INT2); also elsewhere on the board
VPP_!MCLR!: PICKIT3.1, R15.2, U17.7 (!MCLR/VPP/RG5), VPP!MCLR!.P$1, VPP!MCLR!.P$2

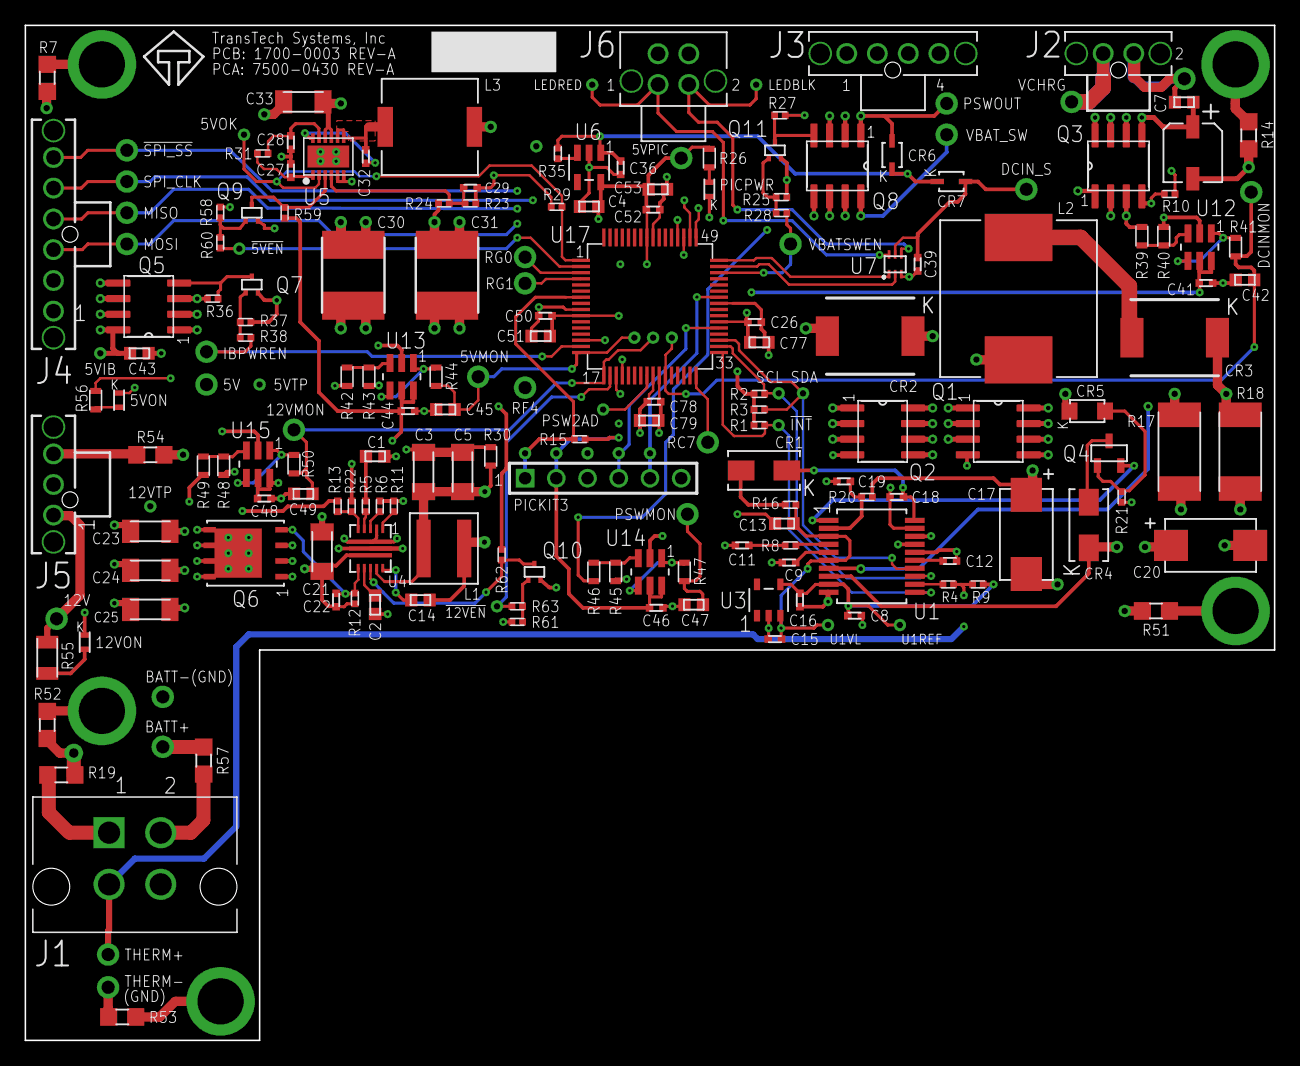
[picture p30: board 1700-0003_PowerBoard_REV-A.brd from above]

Board: 4 copper layers, 101.6 x 82.5 mm, 205 parts (0 on the bottom side), 100 nets.
