eSpark-Backup/eyadkishawi-powerinterface/(commit log)

2024-07-11 #1 Updated files
    [7500-0430_PowerBoard_v1.0.PrjPcb, PowerBoard_7500-0430.PcbDoc, Sheet2.SchDoc, Sheet3.SchDoc]
2024-07-15 #1 Design in Progress
    [1700-0003_PowerBoard_REV-A.PcbDoc, 1700-0003_PowerBoard_REV-A.PrjPcb, 1700-0003_PowerBoard_REV-A.brd, 1700-0003_PowerBoard_REV-A.sch, 1700-0003_PowerBoard_REV-A_0.SchDoc, 1700-0003_PowerBoard_REV-A_1.SchDoc, 7500-0430_PowerBoardAssy_BOM_Rev-A.xlsx, 7500-0430_PowerBoard_v1.0.PrjPcb]
2024-07-15 #1 Eagle files Deliverables Generate.
    [1700-0003_PowerBoard_REV-A.dxf, 1700-0003_PowerBoard_REV-A.step, 1700-0003_PowerBoard_REV-A.xlsx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]
2024-07-18 #1 Eagle gerbers added.
    [1700-0003_PowerBoard_REV-A.brd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]
2024-07-19 #1 Schematic completed
    [1700-0003_PowerBoard_REV-A_0.SchDoc, 7500-0430_PowerBoard_v1.0.PrjPcb, Controller_Sheet.SchDoc, PowerBoard_7500-0430.PcbDoc, Power_Sheet.SchDoc, Regulator_Sheet.SchDoc, Top_Sheet.SchDoc]
2024-07-22 Placement in progress
    [PowerBoard_7500-0430.PcbDoc]
2024-07-23 #2 resistor updated due to footprint and Placement in Progress
    [Controller_Sheet.SchDoc, PowerBoard_7500-0430.PcbDoc, Power_Sheet.SchDoc, Regulator_Sheet.SchDoc]
2024-07-24 #1 Placement done Routing in progress
    [Controller_Sheet.SchDoc, PowerBoard_7500-0430.PcbDoc, Power_Sheet.SchDoc, Regulator_Sheet.SchDoc]
2024-07-25 #1 Routing in Progress
    [PowerBoard_7500-0430.PcbDoc]
2024-07-29 #1 Routing completed
    [1700-0003_PowerBoard_REV-A.PcbDoc, 7500-0430_PowerBoard_v1.0.PrjPcb, PowerBoard_7500-0430.PcbDoc, Power_Sheet.SchDoc]
2024-07-30 #1 Logo added
    [PowerBoard_7500-0430.PcbDoc]
2024-08-01 #4 In-progress.
    [1700-0003_PowerBoard_REV-A.PcbDoc, 7500-0430_PowerBoard_v1.0.PrjPcb, Client BOM.xlsx, PowerBoard_7500-0430.PcbDoc, Power_Sheet.SchDoc]
2024-08-02 #4 Client BOM update.
    [Client BOM.xlsx]
2024-08-02 #4 Deliverables Generated after minor corrections in Routing.
    [7500-0430_PowerBoard_v1.0.PrjPcb, Centroid_File_7500-0430.csv, Controller_Sheet.SchDoc, PCB_PowerBoard_7500-0430.DWG, PCB_PowerBoard_7500-0430.DXF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]
2024-08-04 #3 Corrections in Schematic of Power Baord.
    [PowerBoard_7500-0430.PrjPcb, Power_Sheet.SchDoc, Regulator_Sheet.SchDoc]
2024-08-04 #4 Fresh Deliverables along with Client BOM Generated for Power Board.
    [Centroid_File_7500-0430.csv, Client BOM.xlsx, Controller_Sheet.SchDoc, PCB_PowerBoard_7500-0430.DWG, PCB_PowerBoard_7500-0430.DXF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]
2024-08-05 Folder readjustment (minor)
    [Centroid_File_7500-0430.csv, Client BOM.xlsx, Controller_Sheet.SchDoc, PCB_PowerBoard_7500-0430.DWG, PCB_PowerBoard_7500-0430.DXF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]
2024-08-12 #3 netlabel updated mention in issue
    [PowerBoard_7500-0430.PrjPcb, Regulator_Sheet.SchDoc, Top_Sheet.SchDoc]
2024-08-13 Schematic PCB updated acc to changes mention in #3 #4 Deliverables and BOM updated too
    [1700-0003_PowerBoard_REV-A_1.SchDoc, Centroid_File_7500-0430.csv, Centroid_file.csv, Client BOM.xlsx, Controller_Sheet.SchDoc, PCB_PowerBoard_7500-0430.DWG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]
