eSpark-Backup/eyadkishawi-powerinterface/(notices)

Notices in the files:
parts and their libraries:
TTECH: COPYRIGHT: Copyright (C) 2022 Ultra Librarian. All rights reserved.
TTECH: COPYRIGHT: Copyright (C) 2023 Ultra Librarian. All rights reserved.
